lewisMW/agriculture-SoC/nanosoc/nanosoc_tech/nanosoc/slcorem0_tech/README.md

# SLCore M0 Tech

## SLCore-M0
SLCore M0 is a SoCLabs custom wrapper around the Arm Cortex-M0 designed to be integrated within the NanoSoC SoC.
