lewisMW/agriculture-SoC/analog/comparator_lib/comparator_v1_docs.md

# Comparator Documentation v1 @Today 8:59 AM

<aside>
💡

Block only works for DC input. If above 1V, the output is the high voltage, and if below, the output is the low voltage. 

</aside>

Quick results from February 17, 2026 9:04 AM:



Comparator Verilog A code 



Comparator testbench



5V DC input, 



500mV DC input
