lewisMW/agriculture-SoC/nanosoc/nanosoc_tech/doc/nanosoc_configuration_manual.pdf

# nanoSoC Configuration Manual

SoC Labs (http://www.soclabs.org)

October 30, 2025

Additional information.

You must run ’source set env.sh’ from the accelerator-project directory every time you open a new terminal!

Preamble, copyrights licenses etc.

1

# Contents

1 Introduction | 3
2 Adding your IP | 6
3 Simulating nanoSoC | 9
4 FPGA Flow | 12
5 ASIC Flow | 13

2

# Chapter 1

# Introduction

## 1.1 Summary

## 1.2 Repository Structure

The nanosoc-tech repository should be included as part of the accelerator-project repository. To use nanosoc please make sure you have cloned the accelerator-project repository as this contains IP that nanosoc needs in order to run correctly.
You can clone the accelerator-project using the command:
1 | git clone -- recurse - submodules \
2 | https :// git . soton . ac . uk / soclabs / accelerator - project . git
Below is the repository structure showing all the dependancies from the top level accelerator-project.
- accelerator-project (top level)

– accelerator-wrapper-tech (https://git.soton.ac.uk/soclabs/accelerator_wrapper_tech) – asic-lib-tech (https://git.soton.ac.uk/soclabs/asic_library_tech)
– fpga-lib-tech (https://git.soton.ac.uk/soclabs/fpga_lib_tech)
– generic-lib-tech (https://git.soton.ac.uk/soclabs/generic_lib_tech)
– nanosoc-tech (https://git.soton.ac.uk/soclabs/nanosoc_tech)
∗ sl-ams-tech (https://git.soton.ac.uk/soclabs/sl_ams_tech)
∗ slcorem0-tech (https://git.soton.ac.uk/soclabs/slcorem0_tech)
∗ sldma230-tech (https://git.soton.ac.uk/soclabs/sldma230_tech)
∗ sldm350-tech (https://git.soton.ac.uk/soclabs/sldma350_tech)
∗ socdebug-tech (https://git.soton.ac.uk/soclabs/socdebug_tech)
∗ synopsys-28nm-slm-integration (https://git.soton.ac.uk/soclabs/synopsys_28nm_slm_integration) – rtl-primitives-tech (https://git.soton.ac.uk/soclabs/rtl_primitives_tech)
– soctools-flow (https://git.soton.ac.uk/soclabs/soctools_flow)

3

## 1.3 IP

The nanoSoC reusable SoC platform relies on IP’s from certain vendors. In order to build the system you will need the following IP.

### 1.3.1 Arm(R)

Arm IP should be downloaded from Arm and placed into the recommended IP directories.

- Cortex-M0
- Corstone-101
- (Optional) PL230
- (Optional) DMA-350

### 1.3.2 SoCLabs

SoCLabs IP is all open domain and the repositories for these are automatically cloned into the nanosoc tech directories when you run a git clone.

- ASCII Debug Protocol Controller (SoCDebugTech Git) (https://git.soton.ac.uk/soclabs/socdebug_tech)
- FT1248 Controller (SoCDebugTech Git) (https://git.soton.ac.uk/soclabs/socdebug_tech)
- EXTIO Controller ( EXTIO8x4-axis Git) (https://git.soton.ac.uk/soclabs/extio8x4-axis)
- (Optional) PLL (for TSMC 65nm)
- (Optional) ADC (for TSMC 65nm)
- (Optional) DAC (for TSMC 65nm)

### 1.3.3 Synopsys

Synopsys IP is only used for chips that are taped out on a TSMC 28nm HPC+ node.

- (Optional) 3 GHz PLL
- (Optional) Silicon Lifetime Management

4

Additional information.

You must run ’source set env.sh’ from the accelerator-project directory every time you open a new terminal!

## 1.4 Environment Variables

When you run ’source set env.sh’ it sets up environment variables that are used by the tools (simulators, fpga, synthesis etc.). The main ones that are important for developing your IP are:
$SOCLABS PROJECT DIR - points to the accelerator-project directory $ACCELERATOR DIR - points to your accelerator directory

$ACCELERATOR DIR can be set up in the accelerator-project/env/dependency env.sh file using:

1 export ACCELERATOR \ _DIR =" $SOCLABS \ _PROJECT \ _DIR /** Your -IP - directory **"

5

# Chapter 2

# Adding your IP

In order to add the files for your IP there are 2 options. Either as a local version of your project or as a remote version.

1. Local version: you can just place your IP files into a new directory or in the system/src directory
2. Remote version: you can fork the accelerator-project git to your own git account, this allows you to add your IP either in the system/src directory or as a git submodule.

## 2.1 Integrating your IP

There are 2 steps to integrating your IP in nanosoc

1. Include your IP in the file list
2. Instantiate your IP in the system/src/accelerator subsystem.v file

For step 1. you can add paths to your files in the flist/project/accelerator.flist file. We recommend that you use the environment variables as mentioned in section 1.4. In order for fpga and asic flows to work properly you should split verilog and system verilog files into seperate .flist files. We suggest adding an accelerator sv.flist to the accelerator-project/flist/project directory and adding the following to accelerator.flist

-f $SOCLABS P ROJECT DIR/flist/project/accelerator sv.flist

For step 2. you need to edit the accelerator subsystem.v file (found in accelerator-project/system/src/). The ports of this file are an AHB-lite port, 2x EXP DRQ (data request from accelerator to DMA), 2x EXP DLAST (last signal from DMA to accelerator), 4x EXP IRQ (Interrupts from accelerator to CPU), and some AXI stream interfaces (these are only there if the DMA350 is configured with stream interfaces)

6

Additional information.

Add the option ACCELERATOR=yes to to include your accelerator when you run make commands!

## 2.2 Configuring nanoSoC

The nanoSoC reference design allows for some configuration flexibility. Most of these configuration options are in the accelerator-project/nanosoc.config file. In order to change this configuration, put a ’yes’ next to the relevant options to include these options, otherwise leave it blank.

### 2.2.1 DMA config

The DMA options are fundamentally:

- 1x PL230
- 2x PL230
- 1x DMA350

More details on these DMA IP’s are available from the Arm website.
The DMA-350 also has some extra configuration options
- DMA350 SMALL - Small configuration of DMA, 2 channels, no stream interface, no extended features
- DMA350 DEFAULT - Default configuration of DMA, 2 channels, stream interface, extended features
- DMA350 BIG - Big configuration of DMA, 3 channels, stream interface, extended features

If you use either the SMALL or BIG options for this, you must reconfigure the DMA-350. Follow the below steps:

1. cd to accelerator-project/nanosoc tech/nanosoc/sldma350 tech
2. run ’make clean ip’
3. run ’make config dma ahb small’ or ’make config dma ahb big’

## 2.3 Mixed signal IP

! Still under development !
You can also include mixed signal IP in this design. In order to do this you must also have the relevant IP for this

7

## 2.4 Synopsys IP

! Still under development !
If you are taping out with a TSMC 28nm node, and also have access to the Synopsys IP mentioned in section 1.3.3

8

# Chapter 3

# Simulating nanoSoC

## 3.1 Supported Simulators

- Mentor Graphics: QuestaSim
- Synopsys: VCS
- Cadence: Xcelium
- Icarus Verilog

## 3.2 Running Simulations

You can run make commands from the nanosoc tech directory to run the simulation.

1 | make run SIM = x TESTNAME =y ACCELERATOR = yes

Where x=mti, vcs, xm, or iverilog for QuestaSim, VCS, Xcelium, or Icarus Verilog respectively. And y is the name of the test, the default test is hello (a hello world example).
Or to run the simulation in the GUI you can use:
1 | make sim SIM = x TESTNAME =y ACCELERATOR = yes

Whilst the simulation is running, you should see the output from the UART std out channel in the console/terminal.

## 3.3 Adding Tests

To add your own testcodes to run on nanosoc in the simulation environment, you can add these to the accelerator-project/system/testcodes directory.

1. Create a new directory for your testcode

9

2. Create a .c source file with the same name as the directory
3. Copy the makefile from one of the example testcodes to your test code directory
4. Edit the TESTNAME variable in the new makefile to the name of your test
5. If you want to run any ADP code before your test, add an adp.cmp file (example in the adp v4 cmd tests)
6. If you want to preload expansion memories, add an expram l.hex and/or expram h.hex
7. Add the name of your test to the accelerator-project/system/software list.txt file

### 3.3.1 Creating your C code

The below code is a basic layout for your C code. It initialises the standard out channel over UART. You can then use printf statements that will output over UART, which will be printed on the console output.
The UartEndSimulation() function sends an escape character over UART, which the testbench will use to end the simulation.
1 | # include " CMSDK_CM0 .h"
2 | # include " uart_stdout .h"
3 | # include < stdio .h >

4
5 | int main ( void ) {
6 | // Initialise the UART standard out channel
7 | UartStdOutInit () ;

8
9 | printf ("Foo\n"); // Print over UART stdout

10
11 | /* Insert your code here */

12
13 | // End simulation by sending escape char
14 | UartEndSimulation () ;
15 | return 0;
16 | }
Listing 3.1: Basic Template

For more detailed C code templates, please see the firmware in the accelerator-project/nanosoc tech/software/common/validation. These are also the testcodes used for validating nanoSoC.

### 3.3.2 Preloading expansion memories

You may want to load test vectors directly into the expansion memories to run your tests. Doing this can save space in the instruction memory space as you then don’t have to load data in as arrays or vectors in your testcode. Instead

10 you can use the simulator to automatically load these memories at the start of simulation.
To do this, simply add an ”expram l.hex” file and/or ”expram h.hex” file to your testcode directory. These files will then be loaded to the EXPRAM L or EXPRAM H region repectively. These can then be addressed in your testcode from 0x80000000 for EXPRAM L and 0x90000000 for EXPRAM H.
The expram l.hex files must be ASCII text files with a single byte per line. They will look very similar to the .hex files that are used to preload the instruction memory.

11

# Chapter 4

# FPGA Flow

## 4.1 Summary

## 4.2 Building the FPGA image

To build the FPGA image, run the below command from the nanosoc tech directory:

1 | make build_fpga ACCELERATOR = yes FPGA =x

Where x is either zcu104, mps3, kr260, kv260, z2. If you would like another FPGA target to be included please contact the soclabs team or raise an issue on the accelerator-project git.

## 4.3 Running test code on the FPGA

12

# Chapter 5

# ASIC Flow

## 5.1 Technology Selection

When taping out any design it is important to consider the technology node. The choice of node will impact the power, performance and area (PPA) metrics. And along with area, the cost will also vary from node to node. Below we have compiled some metrics on nanosoc with different nodes and configurations

Technology Node | Configuration | Max
Freq (MHz)

Area
(mm²
)
TSMC 65nm (12-track) | 16kB IMEM and DMEM
8kB EXPRAM L and H | 240 | 1.5
TSMC 65nm (12-track) | 16kB IMEM and DMEM
16kB EXPRAM L and H | 240 | 2
GF 180 | 8kB IMEM and DMEM
4kB EXPRAM L and H | 50 | 6

## 5.2 Cadence ASIC Flow: TSMC 65nm

The following shows how to run the ASIC flow using Cadence Software for a TSMC 65nm implementation

1 | make gen_memories
2 | make flist_genus_nanosoc ASIC = yes ACCELERATOR = yes NODE =65
3 | make cadence_synthesis ASIC = yes NODE =65
4 | make cadence_pnr_setup ASIC = yes NODE =65

13
