lewisMW/agriculture-SoC/nanosoc/nanosoc_tech/testcodes/excluded_tests.txt

rtx_demo
gpio_tests
dma350_stream_tests
uart_tests
uart_driver_tests
