lewisMW/agriculture-SoC/nanosoc/nanosoc_tech/testcodes/software_list.txt

rtx_demo
gpio_tests
hello
dhry
sleep_demo
dualtimer_demo
self_reset_demo
watchdog_demo
timer_tests
debug_tests
default_slaves_tests
dma_tests
dma350_tests
gpio_driver_tests
timer_driver_tests
apb_mux_tests
memory_tests
romtable_tests
interrupt_demo
dataio_tests
dataio_dma230_tests
