lewisMW/agriculture-SoC/nanosoc/system/testcodes/software_list.txt

adc_trigger_test
fifo_drain_test
rtc_time_test
adc_autonomous_test
