lewisMW/agriculture-SoC/nanosoc/nanosoc_tech/hostio4/tb/asc-test.txt

0123456789ABCDEF
123456789ABCDEF
3456789ABCDEF
456789ABCDEF
56789ABCDEF
6789ABCDEF
789ABCDEF
89ABCDEF
9ABCDEF
ABCDEF
BCDEF
CDEF
DEF
EF
EF
abcdefghijklmnopqrstuvwxyz
abcdefghijklmnopqrstuvwxyz
abcdefghijklmnopqrstuvwxyz
abcdefghijklmnopqrstuvwxyz
abcdefghijklmnopqrstuvwxyz
abcdefghijklmnopqrstuvwxyz
abcdefghijklmnopqrstuvwxyz
abcdefghijklmnopqrstuvwxyz
*END*
