lewisMW/agriculture-SoC/(threads)

Thread 3 (2024-05-17):

Project submission form + Milestones

lewisMW, 2024-05-17:
Fill out the project submission form and milestones [here](https://unisydneyedu-my.sharepoint.com/:w:/g/personal/lwat0045_uni_sydney_edu_au/ETINbAPwxZhPrn57SC2FBakBDUp79QfLtQkZGyDaJh7H_g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).
- Body: Hee, Jaime, Shin
- Milestones: Patrick, KeZhi, Erick, Adrian, Daniel, Josh

pgaft, 2024-05-20:
Milestone: Determine which ARM IP are applicable to our design.

pgaft, 2024-05-20:
Milestone: Determine project scope and focus.

pgaft, 2024-05-20:
Generic Milestone: <ARM IP> implementation and interfacing

womba, 2024-05-20:
Milestone: Verification of Digital Design?

womba, 2024-05-20:
Milestone: Software configuration and programming.

AbacusIsMad, 2024-05-20:
Milestone: run example design flow using cortex-M0 (placeholder) and GPIO for familiarity

Closed 2024-05-31.

Thread 8 (2024-12-11):

Create AHB or APB wrappers.

lewisMW, 2024-12-11:
o	Investigate the Wrapper files in SoC Contest 2024/Resources/SoC-design-and-prototyping-Research-Enablement-Kit/cm0_soc_code/cm0_fpu/hw/wrappers/.
o	Create a wrapper for the ADC, like the one from  https://soclabs.org/project/adc-integration-nanosoc.

- Consider where to put timer
- Consider how to go about doing APB interface

sandinj, 2024-12-11:
Drafted address specifications, and edited wrapper to reflect these specifications.

sandinj, 2025-01-24:
Formalised address specifications and documentation, including specifying address offsets. These addresses have been implemented in verilog.

Closed 2025-02-02.

Thread 10 (2025-01-15):

RTC/Timer IP

lewisMW, 2025-01-15:
- [x] Implement or find IP that suit spec.
- [x] Instantiate the IP into the wrapper code.
- [ ] Create a simple FSM to control the IP's (APB interface) - you will need to make sure the timing is correct as per the Arm documentation.
- [ ] Create a simple unit test (e.g. traversing the FSM).
- [ ] Create specs, docs and unit test description (input/output/description) [here:](https://unisydneyedu-my.sharepoint.com/:w:/g/personal/lwat0045_alumni_sydney_edu_au/EZJQlrRwf0pDgi94zrjHnGgBlbid-Y7o1PqV0c9euZl2bg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)

pgaft, 2025-01-28:
Found the PL031 RTC which is a suitable IP for this use case. Since we are currently unable to access AAA IP, a dummy RTC has been implemented on the adc-apb-wrapper branch.

lewisMW, 2025-02-02:
@pgaft I've just checked and we should have access to https://developer.arm.com/downloads/view/PL031?sortBy=availableBy&revision=r1p3-00rel0-2 now.

Closed 2025-04-04.

Thread 11 (2025-01-15):

Design Specs

lewisMW, 2025-01-15:
**4/2/25**
Create specs for each block. Document in the OneDrive!

**26/6/2024**
Sensor types discussed in meeting 26/6/24.
* See Discord for info.
* Add to the OneDrive in the Analog team folder. Use Word or Excel or simply a Markdown file.

**Guide**: Start by imagining a live demonstration of the SoC (on PCB) with sensors at a conference poster session. This can be a fairly controlled environment. What specifications are required for this demo? Per sensor, system level then per component, etc.

EGoliath, 2025-01-19:
https://unisydneyedu-my.sharepoint.com/:w:/g/personal/lwat0045_uni_sydney_edu_au/EY3tUiBB1OVOr_8obefjqW4B51tYOqsHgOD0_Yqsru4BOQ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

moiseskim98, 2025-02-15:
The document that is currently under work is [https://unisydneyedu-my.sharepoint.com/:w:/g/personal/lwat0045_alumni_sydney_edu_au/EW3dMYCGrS5BoNUJLPtlWuYB4M3Je95smwskv35AX_L_Bg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](link)

It includes the theory of the principle used by the sensor, high level specs, and the proposed design for this project

Closed 2025-09-29.

Thread 24 (2025-02-16):

Investigate M0 sleep features

lewisMW, 2025-02-16:
- [x] Read the ARM docs on [M0 power management](https://developer.arm.com/documentation/dui0497/a/the-cortex-m0-processor/power-management) to get an idea of what Cortex M0 features we can use to optimise for a low-power design.
- [x] Determine the feasibility of our design being able to use the _**deep sleep**_ state and what we need to do to use it - how do we put the processor in deep sleep and how do we wake it up?

Kezhipu, 2025-02-22:
feasibility of our design being able to use the deep sleep state：
Based on our agricultural SoCs for sensing and monitoring of field environments, it is important to balance sensing accuracy with power consumption to meet long endurance.And sensors are often “event” driven : when a sensor detects an abnormality (sudden drop in humidity, gas concentration exceeding the limit, etc.), the SoC needs to wake up in time to handle the situation. Most of the time, it can be put to sleep to save energy.
From Doc, we know that the Cortex-M0 core supports two low-power states: Sleep and Deep Sleep：
Deep Sleep can further turn off the system clock and some peripherals such as PLL and Flash memory, which is more power efficient than normal Sleep.
**But from the discussion with Lewis last week, we may need to keep some of the clocks off. (basically feasible)**
And in Deep Sleep, traditional interrupts cannot directly wake up the processor because the main clock may be turned off; while WIC (Wakeup Interrupt Controller) monitors the interrupt line and quickly restores the system clock and wakes up the kernel when it detects a valid signal. This helps to significantly reduce standby power consumption while still maintaining real-time response to external sensors or events. So WIC is a must.

Kezhipu, 2025-02-22:
Entering Deep Sleep Mode

**1. Setting the SLEEPDEEP bit：**
    Before entering Deep Sleep, you need to set the SLEEPDEEP bit in the System Control Register (SCB->SCR).
**2. Execute the sleep command**
    **__WFI()** (Wait For Interrupt) or **__WFE()** (Wait For Event) can be selected：
    __WFI() (Wait For Interrupt): Immediately goes to sleep after execution and waits for interrupt to wake up.
    __WFE() (Wait For Event): if there is no “event” flag, then sleep, otherwise execution continues.
Personally, I think our best choice is **WFI** because it is the most energy efficient, completely stopping until an external interrupt is triggered. And it can be used in conjunction with WIC, and as we can see later, the way we wake up also depends entirely on the way we go to sleep!
   3.Of course, in order to further reduce power consumption, peripherals that are not relevant to the current stage can be turned off by the clock controller or a lower frequency clock source can be used. For example we can keep only the low power timers or critical paths like GPIO input detection.

Kezhipu, 2025-02-22:
Wake Up from Deep Sleep Mode:

As I said before, the mothed of waking up depends on how do we enter deep sleep:
Since we are using WFI, and since the Cortex-M0 shuts down system clocks in deep sleep, traditional interrupt detection won’t work. We have to use **WIC** and even without needing the main clock!

Closed 2025-03-01.

Thread 33 (2025-07-07):

RTL Verification

lewisMW, 2025-07-07:
Complete porting over the integration tests from DesignStart to NanoSoC.

lewisMW, 2025-08-12:
1.5hr
* Converted old tests to new tests (5x tests?)
3hr
* Setup ARM IP (From @lewisMW docs)
* Setup NanoSoC (from readme above)
* Run tests
* Debugging (please DM @lewisMW if you get stuck).

lewisMW, 2025-08-28:
26/8 to 2/9: 3hr
-  [ ] Debugging (please DM @lewisMW if you get stuck).

lewisMW, 2025-09-09:
9/9 to 16/9: 3hrs
- [ ] PR
- [ ] Create new random tests.

lewisMW, 2025-09-16:
16/9 to 23/9: 0.5hrs
- [ ] printf format study
23/9 to 30/9
- [ ] PR for test fixes
- [ ] Create new random tests.

lewisMW, 2025-09-22:
22/9 - 29/9: 4hrs
- [ ] PR for test fixes
- [ ] Create new random tests.
- [ ] printf format study

lewisMW, 2025-09-29:
29/9 - 6/10: ?
- [ ] PR for test fixes
- [ ]

Thread 36 (2025-07-07):

RTL Verification (FPGA)

lewisMW, 2025-07-07:
Verify our custom RTL + NanoSoC on an FPGA, with mock ADC input.

lewisMW, 2025-08-12:
12/8 to 19/8: 5hr
* Get NanoSoC on the FPGA (without our IP)
* Ask Daniel for help (don't be shy)

lewisMW, 2025-08-28:
26/8 to 2/9: 2hrs
- [ ] Super quick follow up to Daniel tomorrow
- [ ] Fiddle around with FPGA build - Getting Windows Vivado to speak to WSL NanoSoC

lewisMW, 2025-09-29:
29/9 - 6/10: 2hrs
- [ ] Upload to the board.

pgaft, 2025-10-06:
6/10 - 13/10: 2 hrs

- [ ]  Ideate how to verify our design on the board.

Thread 38 (2025-08-25):

Understand "ADC integration in nanoSoC"

moiseskim98, 2025-08-25:
Read [ADC integration in nanoSoC](https://soclabs.org/project/adc-integration-nanosoc).

Understand the scope of the project, SAR ADC principle, and requirements.
Understand the workflow of the project. Requirements -> Verilog AMS -> Simulation -> Schematic -> Simulation
Identify key components, e.g., op-amp for the comparator, ADC functional blocks (Comparator, DAC, sample and hold).

Closed 2025-09-20.

Thread 41 (2025-09-20):

Filter

moiseskim98, 2025-09-20:
Low pass filter as a pre stage to the ADC. Build verilog AMS block

lewisMW, 2025-09-29:
22/9 - 29/9: ?hrs
- [ ] ?

lewisMW, 2025-09-29:
29/9 - 6/10: 0.5hrs (Jaime)
- [ ] Look at how to port over the Gain AMS model over.
