lewisMW/agriculture-SoC/nanosoc/nanosoc_tech/fpga/targets/pynq_zcu104/fpga_pinmap.xdc

##################################################################################
##                                                                              ##
## ZCU104 Rev1.0 Master XDC                                                     ##
##                                                                              ##
##################################################################################

#Other net   PACKAGE_PIN V17      - SYSMON_DXN                Bank   0 - DXN
#Other net   PACKAGE_PIN V18      - SYSMON_DXP                Bank   0 - DXP
#Other net   PACKAGE_PIN R17      - SYSMON_AGND               Bank   0 - GNDADC
#Other net   PACKAGE_PIN AA12     - 3N5824                    Bank   0 - POR_OVERRIDE
#Other net   PACKAGE_PIN AA13     - 3N5822                    Bank   0 - PUDC_B
#Other net   PACKAGE_PIN R18      - FPGA_SYSMON_AVCC          Bank   0 - VCCADC
#Other net   PACKAGE_PIN U17      - SYSMON_VN_R               Bank   0 - VN
#Other net   PACKAGE_PIN T18      - SYSMON_VP_R               Bank   0 - VP
#Other net   PACKAGE_PIN T17      - SYSMON_AGND               Bank   0 - VREFN
#Other net   PACKAGE_PIN U18      - SYSMON_AGND               Bank   0 - VREFP
#set_property PACKAGE_PIN B21      [get_ports "5N7582"] ;# Bank  28 VCCO - VCC1V8   - IO_L24N_T3U_N11_28
#set_property IOSTANDARD  LVCMOSxx [get_ports "5N7582"] ;# Bank  28 VCCO - VCC1V8   - IO_L24N_T3U_N11_28
#set_property PACKAGE_PIN B20      [get_ports "5N7577"] ;# Bank  28 VCCO - VCC1V8   - IO_L24P_T3U_N10_28
#set_property IOSTANDARD  LVCMOSxx [get_ports "5N7577"] ;# Bank  28 VCCO - VCC1V8   - IO_L24P_T3U_N10_28
#set_property PACKAGE_PIN A23      [get_ports "5N7578"] ;# Bank  28 VCCO - VCC1V8   - IO_L23N_T3U_N9_28
#set_property IOSTANDARD  LVCMOSxx [get_ports "5N7578"] ;# Bank  28 VCCO - VCC1V8   - IO_L23N_T3U_N9_28
#set_property PACKAGE_PIN A22      [get_ports "5N7569"] ;# Bank  28 VCCO - VCC1V8   - IO_L23P_T3U_N8_28
#set_property IOSTANDARD  LVCMOSxx [get_ports "5N7569"] ;# Bank  28 VCCO - VCC1V8   - IO_L23P_T3U_N8_28
#set_property PACKAGE_PIN B19      [get_ports "5N7570"] ;# Bank  28 VCCO - VCC1V8   - IO_L22N_T3U_N7_DBC_AD0N_28
#set_property IOSTANDARD  LVCMOSxx [get_ports "5N7570"] ;# Bank  28 VCCO - VCC1V8   - IO_L22N_T3U_N7_DBC_AD0N_28
#set_property PACKAGE_PIN B18      [get_ports "5N7565"] ;# Bank  28 VCCO - VCC1V8   - IO_L22P_T3U_N6_DBC_AD0P_28
#set_property IOSTANDARD  LVCMOSxx [get_ports "5N7565"] ;# Bank  28 VCCO - VCC1V8   - IO_L22P_T3U_N6_DBC_AD0P_28
#set_property PACKAGE_PIN A21      [get_ports "5N7709"] ;# Bank  28 VCCO - VCC1V8   - IO_L21N_T3L_N5_AD8N_28
#set_property IOSTANDARD  LVCMOSxx [get_ports "5N7709"] ;# Bank  28 VCCO - VCC1V8   - IO_L21N_T3L_N5_AD8N_28
#set_property PACKAGE_PIN A18      [get_ports "5N7704"] ;# Bank  28 VCCO - VCC1V8   - IO_L19P_T3L_N0_DBC_AD9P_28
#set_property IOSTANDARD  LVCMOSxx [get_ports "5N7704"] ;# Bank  28 VCCO - VCC1V8   - IO_L19P_T3L_N0_DBC_AD9P_28
#set_property PACKAGE_PIN B23      [get_ports "5N7581"] ;# Bank  28 VCCO - VCC1V8   - IO_T3U_N12_28
#set_property IOSTANDARD  LVCMOSxx [get_ports "5N7581"] ;# Bank  28 VCCO - VCC1V8   - IO_T3U_N12_28
#set_property PACKAGE_PIN F25      [get_ports "5N7703"] ;# Bank  28 VCCO - VCC1V8   - IO_T2U_N12_28
#set_property IOSTANDARD  LVCMOSxx [get_ports "5N7703"] ;# Bank  28 VCCO - VCC1V8   - IO_T2U_N12_28
#set_property PACKAGE_PIN G26      [get_ports "5N7702"] ;# Bank  28 VCCO - VCC1V8   - IO_L18N_T2U_N11_AD2N_28
#set_property IOSTANDARD  LVCMOSxx [get_ports "5N7702"] ;# Bank  28 VCCO - VCC1V8   - IO_L18N_T2U_N11_AD2N_28
#set_property PACKAGE_PIN G25      [get_ports "5N7694"] ;# Bank  28 VCCO - VCC1V8   - IO_L18P_T2U_N10_AD2P_28
#set_property IOSTANDARD  LVCMOSxx [get_ports "5N7694"] ;# Bank  28 VCCO - VCC1V8   - IO_L18P_T2U_N10_AD2P_28
#set_property PACKAGE_PIN C23      [get_ports "5N7693"] ;# Bank  28 VCCO - VCC1V8   - IO_L17N_T2U_N9_AD10N_28
#set_property IOSTANDARD  LVCMOSxx [get_ports "5N7693"] ;# Bank  28 VCCO - VCC1V8   - IO_L17N_T2U_N9_AD10N_28
#set_property PACKAGE_PIN D22      [get_ports "5N7690"] ;# Bank  28 VCCO - VCC1V8   - IO_L17P_T2U_N8_AD10P_28
#set_property IOSTANDARD  LVCMOSxx [get_ports "5N7690"] ;# Bank  28 VCCO - VCC1V8   - IO_L17P_T2U_N8_AD10P_28
#set_property PACKAGE_PIN D24      [get_ports "5N7688"] ;# Bank  28 VCCO - VCC1V8   - IO_L16N_T2U_N7_QBC_AD3N_28
#set_property IOSTANDARD  LVCMOSxx [get_ports "5N7688"] ;# Bank  28 VCCO - VCC1V8   - IO_L16N_T2U_N7_QBC_AD3N_28
#set_property PACKAGE_PIN E24      [get_ports "5N7682"] ;# Bank  28 VCCO - VCC1V8   - IO_L16P_T2U_N6_QBC_AD3P_28
#set_property IOSTANDARD  LVCMOSxx [get_ports "5N7682"] ;# Bank  28 VCCO - VCC1V8   - IO_L16P_T2U_N6_QBC_AD3P_28
#set_property PACKAGE_PIN C22      [get_ports "5N7681"] ;# Bank  28 VCCO - VCC1V8   - IO_L15N_T2L_N5_AD11N_28
#set_property IOSTANDARD  LVCMOSxx [get_ports "5N7681"] ;# Bank  28 VCCO - VCC1V8   - IO_L15N_T2L_N5_AD11N_28
#set_property PACKAGE_PIN C21      [get_ports "5N7678"] ;# Bank  28 VCCO - VCC1V8   - IO_L15P_T2L_N4_AD11P_28
#set_property IOSTANDARD  LVCMOSxx [get_ports "5N7678"] ;# Bank  28 VCCO - VCC1V8   - IO_L15P_T2L_N4_AD11P_28
#set_property PACKAGE_PIN G24      [get_ports "5N7676"] ;# Bank  28 VCCO - VCC1V8   - IO_L14N_T2L_N3_GC_28
#set_property IOSTANDARD  LVCMOSxx [get_ports "5N7676"] ;# Bank  28 VCCO - VCC1V8   - IO_L14N_T2L_N3_GC_28
#set_property PACKAGE_PIN G23      [get_ports "5N7672"] ;# Bank  28 VCCO - VCC1V8   - IO_L14P_T2L_N2_GC_28
#set_property IOSTANDARD  LVCMOSxx [get_ports "5N7672"] ;# Bank  28 VCCO - VCC1V8   - IO_L14P_T2L_N2_GC_28
#set_property PACKAGE_PIN F20      [get_ports "5N7532"] ;# Bank  28 VCCO - VCC1V8   - IO_L10N_T1U_N7_QBC_AD4N_28
#set_property IOSTANDARD  LVCMOSxx [get_ports "5N7532"] ;# Bank  28 VCCO - VCC1V8   - IO_L10N_T1U_N7_QBC_AD4N_28
#set_property PACKAGE_PIN G20      [get_ports "5N7533"] ;# Bank  28 VCCO - VCC1V8   - IO_L10P_T1U_N6_QBC_AD4P_28
#set_property IOSTANDARD  LVCMOSxx [get_ports "5N7533"] ;# Bank  28 VCCO - VCC1V8   - IO_L10P_T1U_N6_QBC_AD4P_28
#set_property PACKAGE_PIN D21      [get_ports "5N7524"] ;# Bank  28 VCCO - VCC1V8   - IO_L9N_T1L_N5_AD12N_28
#set_property IOSTANDARD  LVCMOSxx [get_ports "5N7524"] ;# Bank  28 VCCO - VCC1V8   - IO_L9N_T1L_N5_AD12N_28
#set_property PACKAGE_PIN D20      [get_ports "5N7525"] ;# Bank  28 VCCO - VCC1V8   - IO_L9P_T1L_N4_AD12P_28
#set_property IOSTANDARD  LVCMOSxx [get_ports "5N7525"] ;# Bank  28 VCCO - VCC1V8   - IO_L9P_T1L_N4_AD12P_28
#set_property PACKAGE_PIN H22      [get_ports "5N7520"] ;# Bank  28 VCCO - VCC1V8   - IO_L8N_T1L_N3_AD5N_28
#set_property IOSTANDARD  LVCMOSxx [get_ports "5N7520"] ;# Bank  28 VCCO - VCC1V8   - IO_L8N_T1L_N3_AD5N_28
#set_property PACKAGE_PIN H21      [get_ports "5N7521"] ;# Bank  28 VCCO - VCC1V8   - IO_L8P_T1L_N2_AD5P_28
#set_property IOSTANDARD  LVCMOSxx [get_ports "5N7521"] ;# Bank  28 VCCO - VCC1V8   - IO_L8P_T1L_N2_AD5P_28
#set_property PACKAGE_PIN D19      [get_ports "5N7512"] ;# Bank  28 VCCO - VCC1V8   - IO_L7N_T1L_N1_QBC_AD13N_28
#set_property IOSTANDARD  LVCMOSxx [get_ports "5N7512"] ;# Bank  28 VCCO - VCC1V8   - IO_L7N_T1L_N1_QBC_AD13N_28
#set_property PACKAGE_PIN E19      [get_ports "5N7513"] ;# Bank  28 VCCO - VCC1V8   - IO_L7P_T1L_N0_QBC_AD13P_28
#set_property IOSTANDARD  LVCMOSxx [get_ports "5N7513"] ;# Bank  28 VCCO - VCC1V8   - IO_L7P_T1L_N0_QBC_AD13P_28
#set_property PACKAGE_PIN E20      [get_ports "5N7726"] ;# Bank  28 VCCO - VCC1V8   - IO_T1U_N12_28
#set_property IOSTANDARD  LVCMOSxx [get_ports "5N7726"] ;# Bank  28 VCCO - VCC1V8   - IO_T1U_N12_28
#set_property PACKAGE_PIN H23      [get_ports "5N7508"] ;# Bank  28 VCCO - VCC1V8   - IO_T0U_N12_VRP_28
#set_property IOSTANDARD  LVCMOSxx [get_ports "5N7508"] ;# Bank  28 VCCO - VCC1V8   - IO_T0U_N12_VRP_28
#set_property PACKAGE_PIN H24      [get_ports "5N7509"] ;# Bank  28 VCCO - VCC1V8   - IO_L6N_T0U_N11_AD6N_28
#set_property IOSTANDARD  LVCMOSxx [get_ports "5N7509"] ;# Bank  28 VCCO - VCC1V8   - IO_L6N_T0U_N11_AD6N_28
#set_property PACKAGE_PIN J24      [get_ports "5N7500"] ;# Bank  28 VCCO - VCC1V8   - IO_L6P_T0U_N10_AD6P_28
#set_property IOSTANDARD  LVCMOSxx [get_ports "5N7500"] ;# Bank  28 VCCO - VCC1V8   - IO_L6P_T0U_N10_AD6P_28
#set_property PACKAGE_PIN H26      [get_ports "5N7501"] ;# Bank  28 VCCO - VCC1V8   - IO_L5N_T0U_N9_AD14N_28
#set_property IOSTANDARD  LVCMOSxx [get_ports "5N7501"] ;# Bank  28 VCCO - VCC1V8   - IO_L5N_T0U_N9_AD14N_28
#set_property PACKAGE_PIN J25      [get_ports "5N7496"] ;# Bank  28 VCCO - VCC1V8   - IO_L5P_T0U_N8_AD14P_28
#set_property IOSTANDARD  LVCMOSxx [get_ports "5N7496"] ;# Bank  28 VCCO - VCC1V8   - IO_L5P_T0U_N8_AD14P_28
#set_property PACKAGE_PIN K23      [get_ports "5N7497"] ;# Bank  28 VCCO - VCC1V8   - IO_L4N_T0U_N7_DBC_AD7N_28
#set_property IOSTANDARD  LVCMOSxx [get_ports "5N7497"] ;# Bank  28 VCCO - VCC1V8   - IO_L4N_T0U_N7_DBC_AD7N_28
#set_property PACKAGE_PIN K22      [get_ports "5N7488"] ;# Bank  28 VCCO - VCC1V8   - IO_L4P_T0U_N6_DBC_AD7P_28
#set_property IOSTANDARD  LVCMOSxx [get_ports "5N7488"] ;# Bank  28 VCCO - VCC1V8   - IO_L4P_T0U_N6_DBC_AD7P_28
#set_property PACKAGE_PIN J22      [get_ports "5N7489"] ;# Bank  28 VCCO - VCC1V8   - IO_L3N_T0L_N5_AD15N_28
#set_property IOSTANDARD  LVCMOSxx [get_ports "5N7489"] ;# Bank  28 VCCO - VCC1V8   - IO_L3N_T0L_N5_AD15N_28
#set_property PACKAGE_PIN J21      [get_ports "5N7484"] ;# Bank  28 VCCO - VCC1V8   - IO_L3P_T0L_N4_AD15P_28
#set_property IOSTANDARD  LVCMOSxx [get_ports "5N7484"] ;# Bank  28 VCCO - VCC1V8   - IO_L3P_T0L_N4_AD15P_28
#set_property PACKAGE_PIN K24      [get_ports "5N7485"] ;# Bank  28 VCCO - VCC1V8   - IO_L2N_T0L_N3_28
#set_property IOSTANDARD  LVCMOSxx [get_ports "5N7485"] ;# Bank  28 VCCO - VCC1V8   - IO_L2N_T0L_N3_28
#set_property PACKAGE_PIN L23      [get_ports "5N7476"] ;# Bank  28 VCCO - VCC1V8   - IO_L2P_T0L_N2_28
#set_property IOSTANDARD  LVCMOSxx [get_ports "5N7476"] ;# Bank  28 VCCO - VCC1V8   - IO_L2P_T0L_N2_28
#set_property PACKAGE_PIN L22      [get_ports "5N7477"] ;# Bank  28 VCCO - VCC1V8   - IO_L1N_T0L_N1_DBC_28
#set_property IOSTANDARD  LVCMOSxx [get_ports "5N7477"] ;# Bank  28 VCCO - VCC1V8   - IO_L1N_T0L_N1_DBC_28
#set_property PACKAGE_PIN L21      [get_ports "5N7472"] ;# Bank  28 VCCO - VCC1V8   - IO_L1P_T0L_N0_DBC_28
#set_property IOSTANDARD  LVCMOSxx [get_ports "5N7472"] ;# Bank  28 VCCO - VCC1V8   - IO_L1P_T0L_N0_DBC_28
#Other net   PACKAGE_PIN M23      - 5N7631                    Bank  28 - VREF_28
#set_property PACKAGE_PIN A9       [get_ports "4N9784"] ;# Bank  68 VCCO - VADJ_FMC - IO_T3U_N12_68
#set_property IOSTANDARD  LVCMOSxx [get_ports "4N9784"] ;# Bank  68 VCCO - VADJ_FMC - IO_T3U_N12_68
#set_property PACKAGE_PIN G13      [get_ports "4N9781"] ;# Bank  68 VCCO - VADJ_FMC - IO_T2U_N12_68
#set_property IOSTANDARD  LVCMOSxx [get_ports "4N9781"] ;# Bank  68 VCCO - VADJ_FMC - IO_T2U_N12_68
#set_property PACKAGE_PIN G11      [get_ports "4N9820"] ;# Bank  68 VCCO - VADJ_FMC - IO_L13N_T2L_N1_GC_QBC_68
#set_property IOSTANDARD  LVCMOSxx [get_ports "4N9820"] ;# Bank  68 VCCO - VADJ_FMC - IO_L13N_T2L_N1_GC_QBC_68
#set_property PACKAGE_PIN H11      [get_ports "4N9817"] ;# Bank  68 VCCO - VADJ_FMC - IO_L13P_T2L_N0_GC_QBC_68
#set_property IOSTANDARD  LVCMOSxx [get_ports "4N9817"] ;# Bank  68 VCCO - VADJ_FMC - IO_L13P_T2L_N0_GC_QBC_68
#set_property PACKAGE_PIN G9       [get_ports "4N9823"] ;# Bank  68 VCCO - VADJ_FMC - IO_L11N_T1U_N9_GC_68
#set_property IOSTANDARD  LVCMOSxx [get_ports "4N9823"] ;# Bank  68 VCCO - VADJ_FMC - IO_L11N_T1U_N9_GC_68
#set_property PACKAGE_PIN H9       [get_ports "4N9826"] ;# Bank  68 VCCO - VADJ_FMC - IO_L11P_T1U_N8_GC_68
#set_property IOSTANDARD  LVCMOSxx [get_ports "4N9826"] ;# Bank  68 VCCO - VADJ_FMC - IO_L11P_T1U_N8_GC_68
#set_property PACKAGE_PIN D7       [get_ports "4N9778"] ;# Bank  68 VCCO - VADJ_FMC - IO_T1U_N12_68
#set_property IOSTANDARD  LVCMOSxx [get_ports "4N9778"] ;# Bank  68 VCCO - VADJ_FMC - IO_T1U_N12_68
#set_property PACKAGE_PIN H14      [get_ports "VRP_68"] ;# Bank  68 VCCO - VADJ_FMC - IO_T0U_N12_VRP_68
#set_property IOSTANDARD  LVCMOSxx [get_ports "VRP_68"] ;# Bank  68 VCCO - VADJ_FMC - IO_T0U_N12_VRP_68
#set_property PACKAGE_PIN K13      [get_ports "4N9759"] ;# Bank  68 VCCO - VADJ_FMC - IO_L6N_T0U_N11_AD6N_68
#set_property IOSTANDARD  LVCMOSxx [get_ports "4N9759"] ;# Bank  68 VCCO - VADJ_FMC - IO_L6N_T0U_N11_AD6N_68
#set_property PACKAGE_PIN L14      [get_ports "4N9760"] ;# Bank  68 VCCO - VADJ_FMC - IO_L6P_T0U_N10_AD6P_68
#set_property IOSTANDARD  LVCMOSxx [get_ports "4N9760"] ;# Bank  68 VCCO - VADJ_FMC - IO_L6P_T0U_N10_AD6P_68
#set_property PACKAGE_PIN J14      [get_ports "4N9755"] ;# Bank  68 VCCO - VADJ_FMC - IO_L5N_T0U_N9_AD14N_68
#set_property IOSTANDARD  LVCMOSxx [get_ports "4N9755"] ;# Bank  68 VCCO - VADJ_FMC - IO_L5N_T0U_N9_AD14N_68
#set_property PACKAGE_PIN K14      [get_ports "4N9756"] ;# Bank  68 VCCO - VADJ_FMC - IO_L5P_T0U_N8_AD14P_68
#set_property IOSTANDARD  LVCMOSxx [get_ports "4N9756"] ;# Bank  68 VCCO - VADJ_FMC - IO_L5P_T0U_N8_AD14P_68
#set_property PACKAGE_PIN J11      [get_ports "4N9771"] ;# Bank  68 VCCO - VADJ_FMC - IO_L4N_T0U_N7_DBC_AD7N_68
#set_property IOSTANDARD  LVCMOSxx [get_ports "4N9771"] ;# Bank  68 VCCO - VADJ_FMC - IO_L4N_T0U_N7_DBC_AD7N_68
#set_property PACKAGE_PIN K12      [get_ports "4N9772"] ;# Bank  68 VCCO - VADJ_FMC - IO_L4P_T0U_N6_DBC_AD7P_68
#set_property IOSTANDARD  LVCMOSxx [get_ports "4N9772"] ;# Bank  68 VCCO - VADJ_FMC - IO_L4P_T0U_N6_DBC_AD7P_68
#set_property PACKAGE_PIN L11      [get_ports "4N9767"] ;# Bank  68 VCCO - VADJ_FMC - IO_L3N_T0L_N5_AD15N_68
#set_property IOSTANDARD  LVCMOSxx [get_ports "4N9767"] ;# Bank  68 VCCO - VADJ_FMC - IO_L3N_T0L_N5_AD15N_68
#set_property PACKAGE_PIN L12      [get_ports "4N9768"] ;# Bank  68 VCCO - VADJ_FMC - IO_L3P_T0L_N4_AD15P_68
#set_property IOSTANDARD  LVCMOSxx [get_ports "4N9768"] ;# Bank  68 VCCO - VADJ_FMC - IO_L3P_T0L_N4_AD15P_68
#Other net   PACKAGE_PIN J12      - 4N9503                    Bank  68 - VREF_68
#set_property PACKAGE_PIN J20      [get_ports "7N10213"] ;# Bank  67 VCCO - VADJ_FMC - IO_T3U_N12_67
#set_property IOSTANDARD  LVCMOSxx [get_ports "7N10213"] ;# Bank  67 VCCO - VADJ_FMC - IO_T3U_N12_67
#set_property PACKAGE_PIN J19      [get_ports "7N10210"] ;# Bank  67 VCCO - VADJ_FMC - IO_T2U_N12_67
#set_property IOSTANDARD  LVCMOSxx [get_ports "7N10210"] ;# Bank  67 VCCO - VADJ_FMC - IO_T2U_N12_67
#set_property PACKAGE_PIN G16      [get_ports "FMC_LPC_LA09_N"] ;# Bank  67 VCCO - VADJ_FMC - IO_L18N_T2U_N11_AD2N_67
#set_property PACKAGE_PIN D14      [get_ports "7N10403"] ;# Bank  67 VCCO - VADJ_FMC - IO_L11N_T1U_N9_GC_67
#set_property IOSTANDARD  LVCMOSxx [get_ports "7N10403"] ;# Bank  67 VCCO - VADJ_FMC - IO_L11N_T1U_N9_GC_67
#set_property PACKAGE_PIN D15      [get_ports "7N10406"] ;# Bank  67 VCCO - VADJ_FMC - IO_L11P_T1U_N8_GC_67
#set_property IOSTANDARD  LVCMOSxx [get_ports "7N10406"] ;# Bank  67 VCCO - VADJ_FMC - IO_L11P_T1U_N8_GC_67
#set_property PACKAGE_PIN F13      [get_ports "7N10612"] ;# Bank  67 VCCO - VADJ_FMC - IO_L10N_T1U_N7_QBC_AD4N_67
#set_property IOSTANDARD  LVCMOSxx [get_ports "7N10612"] ;# Bank  67 VCCO - VADJ_FMC - IO_L10N_T1U_N7_QBC_AD4N_67
#set_property PACKAGE_PIN G14      [get_ports "7N10614"] ;# Bank  67 VCCO - VADJ_FMC - IO_L10P_T1U_N6_QBC_AD4P_67
#set_property IOSTANDARD  LVCMOSxx [get_ports "7N10614"] ;# Bank  67 VCCO - VADJ_FMC - IO_L10P_T1U_N6_QBC_AD4P_67
#set_property PACKAGE_PIN E13      [get_ports "7N10207"] ;# Bank  67 VCCO - VADJ_FMC - IO_T1U_N12_67
#set_property IOSTANDARD  LVCMOSxx [get_ports "7N10207"] ;# Bank  67 VCCO - VADJ_FMC - IO_T1U_N12_67
#set_property PACKAGE_PIN C14      [get_ports "7N10204"] ;# Bank  67 VCCO - VADJ_FMC - IO_T0U_N12_VRP_67
#set_property IOSTANDARD  LVCMOSxx [get_ports "7N10204"] ;# Bank  67 VCCO - VADJ_FMC - IO_T0U_N12_VRP_67
#set_property PACKAGE_PIN C12      [get_ports "FMC_LPC_LA14_N"] ;# Bank  67 VCCO - VADJ_FMC - IO_L6N_T0U_N11_AD6N_67
#set_property PACKAGE_PIN B13      [get_ports "7N10197"] ;# Bank  67 VCCO - VADJ_FMC - IO_L4N_T0U_N7_DBC_AD7N_67
#set_property IOSTANDARD  LVCMOSxx [get_ports "7N10197"] ;# Bank  67 VCCO - VADJ_FMC - IO_L4N_T0U_N7_DBC_AD7N_67
#set_property PACKAGE_PIN B14      [get_ports "7N10198"] ;# Bank  67 VCCO - VADJ_FMC - IO_L4P_T0U_N6_DBC_AD7P_67
#set_property IOSTANDARD  LVCMOSxx [get_ports "7N10198"] ;# Bank  67 VCCO - VADJ_FMC - IO_L4P_T0U_N6_DBC_AD7P_67
#set_property PACKAGE_PIN A14      [get_ports "7N10193"] ;# Bank  67 VCCO - VADJ_FMC - IO_L3N_T0L_N5_AD15N_67
#set_property IOSTANDARD  LVCMOSxx [get_ports "7N10193"] ;# Bank  67 VCCO - VADJ_FMC - IO_L3N_T0L_N5_AD15N_67
#set_property PACKAGE_PIN A15      [get_ports "7N10194"] ;# Bank  67 VCCO - VADJ_FMC - IO_L3P_T0L_N4_AD15P_67
#set_property IOSTANDARD  LVCMOSxx [get_ports "7N10194"] ;# Bank  67 VCCO - VADJ_FMC - IO_L3P_T0L_N4_AD15P_67
#set_property PACKAGE_PIN B15      [get_ports "7N10185"] ;# Bank  67 VCCO - VADJ_FMC - IO_L2N_T0L_N3_67
#set_property IOSTANDARD  LVCMOSxx [get_ports "7N10185"] ;# Bank  67 VCCO - VADJ_FMC - IO_L2N_T0L_N3_67
#set_property PACKAGE_PIN B16      [get_ports "7N10186"] ;# Bank  67 VCCO - VADJ_FMC - IO_L2P_T0L_N2_67
#set_property IOSTANDARD  LVCMOSxx [get_ports "7N10186"] ;# Bank  67 VCCO - VADJ_FMC - IO_L2P_T0L_N2_67
#set_property PACKAGE_PIN A16      [get_ports "7N10181"] ;# Bank  67 VCCO - VADJ_FMC - IO_L1N_T0L_N1_DBC_67
#set_property IOSTANDARD  LVCMOSxx [get_ports "7N10181"] ;# Bank  67 VCCO - VADJ_FMC - IO_L1N_T0L_N1_DBC_67
#set_property PACKAGE_PIN A17      [get_ports "7N10182"] ;# Bank  67 VCCO - VADJ_FMC - IO_L1P_T0L_N0_DBC_67
#set_property IOSTANDARD  LVCMOSxx [get_ports "7N10182"] ;# Bank  67 VCCO - VADJ_FMC - IO_L1P_T0L_N0_DBC_67
#Other net   PACKAGE_PIN L18      - 7N9719                    Bank  67 - VREF_67
#set_property PACKAGE_PIN AF10     [get_ports "7N10601"] ;# Bank  66 VCCO - VCC1V2   - IO_L19N_T3L_N1_DBC_AD9N_66
#set_property IOSTANDARD  LVCMOSxx [get_ports "7N10601"] ;# Bank  66 VCCO - VCC1V2   - IO_L19N_T3L_N1_DBC_AD9N_66
#set_property PACKAGE_PIN AC14     [get_ports "7N10603"] ;# Bank  66 VCCO - VCC1V2   - IO_T3U_N12_66
#set_property IOSTANDARD  LVCMOSxx [get_ports "7N10603"] ;# Bank  66 VCCO - VCC1V2   - IO_T3U_N12_66
#set_property PACKAGE_PIN AH8      [get_ports "7N10599"] ;# Bank  66 VCCO - VCC1V2   - IO_T2U_N12_66
#set_property IOSTANDARD  LVCMOSxx [get_ports "7N10599"] ;# Bank  66 VCCO - VCC1V2   - IO_T2U_N12_66
#set_property PACKAGE_PIN AJ12     [get_ports "7N10597"] ;# Bank  66 VCCO - VCC1V2   - IO_L13N_T2L_N1_GC_QBC_66
#set_property IOSTANDARD  LVCMOSxx [get_ports "7N10597"] ;# Bank  66 VCCO - VCC1V2   - IO_L13N_T2L_N1_GC_QBC_66
#set_property PACKAGE_PIN AL13     [get_ports "7N10593"] ;# Bank  66 VCCO - VCC1V2   - IO_L7N_T1L_N1_QBC_AD13N_66
#set_property IOSTANDARD  LVCMOSxx [get_ports "7N10593"] ;# Bank  66 VCCO - VCC1V2   - IO_L7N_T1L_N1_QBC_AD13N_66
#set_property PACKAGE_PIN AM13     [get_ports "7N10595"] ;# Bank  66 VCCO - VCC1V2   - IO_T1U_N12_66
#set_property IOSTANDARD  LVCMOSxx [get_ports "7N10595"] ;# Bank  66 VCCO - VCC1V2   - IO_T1U_N12_66
#set_property PACKAGE_PIN AP8      [get_ports "VRP_66"] ;# Bank  66 VCCO - VCC1V2   - IO_T0U_N12_VRP_66
#set_property IOSTANDARD  LVCMOSxx [get_ports "VRP_66"] ;# Bank  66 VCCO - VCC1V2   - IO_T0U_N12_VRP_66
#set_property PACKAGE_PIN AP12     [get_ports "7N10591"] ;# Bank  66 VCCO - VCC1V2   - IO_L1N_T0L_N1_DBC_66
#set_property IOSTANDARD  LVCMOSxx [get_ports "7N10591"] ;# Bank  66 VCCO - VCC1V2   - IO_L1N_T0L_N1_DBC_66
#Other net   PACKAGE_PIN AB12     - 7N8282                    Bank  66 - VREF_66
#set_property PACKAGE_PIN AE19     [get_ports "6N12439"] ;# Bank  65 VCCO - VCC1V2   - IO_L19N_T3L_N1_DBC_AD9N_65
#set_property IOSTANDARD  LVCMOSxx [get_ports "6N12439"] ;# Bank  65 VCCO - VCC1V2   - IO_L19N_T3L_N1_DBC_AD9N_65
#set_property PACKAGE_PIN AE22     [get_ports "6N12442"] ;# Bank  65 VCCO - VCC1V2   - IO_T3U_N12_65
#set_property IOSTANDARD  LVCMOSxx [get_ports "6N12442"] ;# Bank  65 VCCO - VCC1V2   - IO_T3U_N12_65
#set_property PACKAGE_PIN AF20     [get_ports "6N12436"] ;# Bank  65 VCCO - VCC1V2   - IO_T2U_N12_65
#set_property IOSTANDARD  LVCMOSxx [get_ports "6N12436"] ;# Bank  65 VCCO - VCC1V2   - IO_T2U_N12_65
#set_property PACKAGE_PIN AH23     [get_ports "6N12433"] ;# Bank  65 VCCO - VCC1V2   - IO_L13N_T2L_N1_GC_QBC_65
#set_property IOSTANDARD  LVCMOSxx [get_ports "6N12433"] ;# Bank  65 VCCO - VCC1V2   - IO_L13N_T2L_N1_GC_QBC_65
#set_property PACKAGE_PIN AL21     [get_ports "6N12427"] ;# Bank  65 VCCO - VCC1V2   - IO_L7N_T1L_N1_QBC_AD13N_65
#set_property IOSTANDARD  LVCMOSxx [get_ports "6N12427"] ;# Bank  65 VCCO - VCC1V2   - IO_L7N_T1L_N1_QBC_AD13N_65
#set_property PACKAGE_PIN AH19     [get_ports "6N12430"] ;# Bank  65 VCCO - VCC1V2   - IO_T1U_N12_65
#set_property IOSTANDARD  LVCMOSxx [get_ports "6N12430"] ;# Bank  65 VCCO - VCC1V2   - IO_T1U_N12_65
#set_property PACKAGE_PIN AM20     [get_ports "VRP_65"] ;# Bank  65 VCCO - VCC1V2   - IO_T0U_N12_VRP_65
#set_property IOSTANDARD  LVCMOSxx [get_ports "VRP_65"] ;# Bank  65 VCCO - VCC1V2   - IO_T0U_N12_VRP_65
#set_property PACKAGE_PIN AP20     [get_ports "6N12401"] ;# Bank  65 VCCO - VCC1V2   - IO_L1N_T0L_N1_DBC_65
#set_property IOSTANDARD  LVCMOSxx [get_ports "6N12401"] ;# Bank  65 VCCO - VCC1V2   - IO_L1N_T0L_N1_DBC_65
#Other net   PACKAGE_PIN AB20     - 6N11582                   Bank  65 - VREF_65
#set_property PACKAGE_PIN AA17     [get_ports "6N12707"] ;# Bank  64 VCCO - VCC1V2   - IO_T3U_N12_64
#set_property IOSTANDARD  LVCMOSxx [get_ports "6N12707"] ;# Bank  64 VCCO - VCC1V2   - IO_T3U_N12_64
#set_property PACKAGE_PIN AE17     [get_ports "6N12705"] ;# Bank  64 VCCO - VCC1V2   - IO_L15P_T2L_N4_AD11P_64
#set_property IOSTANDARD  LVCMOSxx [get_ports "6N12705"] ;# Bank  64 VCCO - VCC1V2   - IO_L15P_T2L_N4_AD11P_64
#set_property PACKAGE_PIN AP14     [get_ports "VRP_64"] ;# Bank  64 VCCO - VCC1V2   - IO_T0U_N12_VRP_64
#set_property PACKAGE_PIN AP15     [get_ports "6N12788"] ;# Bank  64 VCCO - VCC1V2   - IO_L5N_T0U_N9_AD14N_64
#set_property IOSTANDARD  LVCMOSxx [get_ports "6N12788"] ;# Bank  64 VCCO - VCC1V2   - IO_L5N_T0U_N9_AD14N_64
#set_property PACKAGE_PIN AP16     [get_ports "6N12789"] ;# Bank  64 VCCO - VCC1V2   - IO_L5P_T0U_N8_AD14P_64
#set_property IOSTANDARD  LVCMOSxx [get_ports "6N12789"] ;# Bank  64 VCCO - VCC1V2   - IO_L5P_T0U_N8_AD14P_64
#set_property PACKAGE_PIN AN14     [get_ports "6N12782"] ;# Bank  64 VCCO - VCC1V2   - IO_L4N_T0U_N7_DBC_AD7N_64
#set_property IOSTANDARD  LVCMOSxx [get_ports "6N12782"] ;# Bank  64 VCCO - VCC1V2   - IO_L4N_T0U_N7_DBC_AD7N_64
#set_property PACKAGE_PIN AM14     [get_ports "6N12783"] ;# Bank  64 VCCO - VCC1V2   - IO_L4P_T0U_N6_DBC_AD7P_64
#set_property IOSTANDARD  LVCMOSxx [get_ports "6N12783"] ;# Bank  64 VCCO - VCC1V2   - IO_L4P_T0U_N6_DBC_AD7P_64
#set_property PACKAGE_PIN AN18     [get_ports "6N12780"] ;# Bank  64 VCCO - VCC1V2   - IO_L3N_T0L_N5_AD15N_64
#set_property IOSTANDARD  LVCMOSxx [get_ports "6N12780"] ;# Bank  64 VCCO - VCC1V2   - IO_L3N_T0L_N5_AD15N_64
#set_property PACKAGE_PIN AM18     [get_ports "6N12781"] ;# Bank  64 VCCO - VCC1V2   - IO_L3P_T0L_N4_AD15P_64
#set_property IOSTANDARD  LVCMOSxx [get_ports "6N12781"] ;# Bank  64 VCCO - VCC1V2   - IO_L3P_T0L_N4_AD15P_64
#set_property PACKAGE_PIN AP13     [get_ports "6N12774"] ;# Bank  64 VCCO - VCC1V2   - IO_L2N_T0L_N3_64
#set_property IOSTANDARD  LVCMOSxx [get_ports "6N12774"] ;# Bank  64 VCCO - VCC1V2   - IO_L2N_T0L_N3_64
#set_property PACKAGE_PIN AN13     [get_ports "6N12775"] ;# Bank  64 VCCO - VCC1V2   - IO_L2P_T0L_N2_64
#set_property IOSTANDARD  LVCMOSxx [get_ports "6N12775"] ;# Bank  64 VCCO - VCC1V2   - IO_L2P_T0L_N2_64
#set_property PACKAGE_PIN AP17     [get_ports "6N12772"] ;# Bank  64 VCCO - VCC1V2   - IO_L1N_T0L_N1_DBC_64
#set_property IOSTANDARD  LVCMOSxx [get_ports "6N12772"] ;# Bank  64 VCCO - VCC1V2   - IO_L1N_T0L_N1_DBC_64
#set_property PACKAGE_PIN AP18     [get_ports "6N12773"] ;# Bank  64 VCCO - VCC1V2   - IO_L1P_T0L_N0_DBC_64
#set_property IOSTANDARD  LVCMOSxxn [get_ports "6N12773"] ;# Bank  64 VCCO - VCC1V2   - IO_L1P_T0L_N0_DBC_64
#Other net   PACKAGE_PIN AG16     - 6N11370                   Bank  64 - VREF_64
#Other net   PACKAGE_PIN AD9      - MGT1V2                    Bank 224 - MGTAVTTRCAL_R
#Other net   PACKAGE_PIN A24      - MIO0_QSPI_LWR_CLK         Bank 500 - PS_MIO0
#Other net   PACKAGE_PIN C24      - MIO1_QSPI_LWR_DQ1         Bank 500 - PS_MIO1
#Other net   PACKAGE_PIN F26      - 53N7803                   Bank 500 - PS_MIO10
#Other net   PACKAGE_PIN B26      - 53N7806                   Bank 500 - PS_MIO11
#Other net   PACKAGE_PIN C27      - 53N7809                   Bank 500 - PS_MIO12
#Other net   PACKAGE_PIN D27      - 53N7788                   Bank 500 - PS_MIO13
#Other net   PACKAGE_PIN A27      - 53N7844                   Bank 500 - PS_MIO14
#Other net   PACKAGE_PIN E27      - 53N7842                   Bank 500 - PS_MIO15
#Other net   PACKAGE_PIN A28      - MIO16_I2C1_SCL            Bank 500 - PS_MIO16
#Other net   PACKAGE_PIN C29      - MIO17_I2C1_SDA            Bank 500 - PS_MIO17
#Other net   PACKAGE_PIN F27      - UART0_TXD_MIO18_RXD       Bank 500 - PS_MIO18
#Other net   PACKAGE_PIN B28      - UART0_RXD_MIO19_TXD       Bank 500 - PS_MIO19
#Other net   PACKAGE_PIN B24      - MIO2_QSPI_LWR_DQ2         Bank 500 - PS_MIO2
#Other net   PACKAGE_PIN E29      - UART1_RXD_MIO20_TXD       Bank 500 - PS_MIO20
#Other net   PACKAGE_PIN C28      - UART1_TXD_MIO21_RXD       Bank 500 - PS_MIO21
#Other net   PACKAGE_PIN F28      - 53N7824                   Bank 500 - PS_MIO22
#Other net   PACKAGE_PIN B29      - 53N7822                   Bank 500 - PS_MIO23
#Other net   PACKAGE_PIN E28      - MIO24_CAN_TX              Bank 500 - PS_MIO24
#Other net   PACKAGE_PIN D29      - MIO25_CAN_RX              Bank 500 - PS_MIO25
#Other net   PACKAGE_PIN E25      - MIO3_QSPI_LWR_DQ3         Bank 500 - PS_MIO3
#Other net   PACKAGE_PIN A25      - MIO4_QSPI_LWR_DQ0         Bank 500 - PS_MIO4
#Other net   PACKAGE_PIN D25      - MIO5_QSPI_LWR_CS_B        Bank 500 - PS_MIO5
#Other net   PACKAGE_PIN A26      - 53N6816                   Bank 500 - PS_MIO6
#Other net   PACKAGE_PIN B25      - 53N7794                   Bank 500 - PS_MIO7
#Other net   PACKAGE_PIN D26      - 53N7797                   Bank 500 - PS_MIO8
#Other net   PACKAGE_PIN C26      - 53N7800                   Bank 500 - PS_MIO9
#Other net   PACKAGE_PIN AA25     - PS_SYSMON_AVCC            Bank 500 - VCC_PSADC
#Other net   PACKAGE_PIN AA24     - PS_SYSMON_AGND            Bank 500 - GND_PSADC
#Other net   PACKAGE_PIN A29      - 53N7791                   Bank 501 - PS_MIO26
#Other net   PACKAGE_PIN A30      - MIO27_DP_AUX_OUT          Bank 501 - PS_MIO27
#Other net   PACKAGE_PIN A31      - MIO28_DP_HPD              Bank 501 - PS_MIO28
#Other net   PACKAGE_PIN A32      - MIO29_DP_OE               Bank 501 - PS_MIO29
#Other net   PACKAGE_PIN A33      - MIO30_DP_AUX_IN           Bank 501 - PS_MIO30
#Other net   PACKAGE_PIN B30      - 53N7736                   Bank 501 - PS_MIO31
#Other net   PACKAGE_PIN B31      - 53N7739                   Bank 501 - PS_MIO32
#Other net   PACKAGE_PIN B33      - 53N7742                   Bank 501 - PS_MIO33
#Other net   PACKAGE_PIN B34      - 53N7745                   Bank 501 - PS_MIO34
#Other net   PACKAGE_PIN C31      - 53N7748                   Bank 501 - PS_MIO35
#Other net   PACKAGE_PIN C32      - 53N7751                   Bank 501 - PS_MIO36
#Other net   PACKAGE_PIN C33      - 53N7754                   Bank 501 - PS_MIO37
#Other net   PACKAGE_PIN C34      - 53N7768                   Bank 501 - PS_MIO38
#Other net   PACKAGE_PIN D30      - 53N7771                   Bank 501 - PS_MIO39
#Other net   PACKAGE_PIN D31      - 53N7773                   Bank 501 - PS_MIO40
#Other net   PACKAGE_PIN D32      - 53N7775                   Bank 501 - PS_MIO41
#Other net   PACKAGE_PIN D34      - 53N7777                   Bank 501 - PS_MIO42
#Other net   PACKAGE_PIN E30      - 53N6798                   Bank 501 - PS_MIO43
#Other net   PACKAGE_PIN E32      - 53N7783                   Bank 501 - PS_MIO44
#Other net   PACKAGE_PIN E33      - MIO45_SDIO_DETECT         Bank 501 - PS_MIO45
#Other net   PACKAGE_PIN E34      - MIO46_SDIO_DAT0_R         Bank 501 - PS_MIO46
#Other net   PACKAGE_PIN F30      - MIO47_SDIO_DAT1_R         Bank 501 - PS_MIO47
#Other net   PACKAGE_PIN F31      - MIO48_SDIO_DAT2_R         Bank 501 - PS_MIO48
#Other net   PACKAGE_PIN F32      - MIO49_SDIO_DAT3_R         Bank 501 - PS_MIO49
#Other net   PACKAGE_PIN F33      - MIO50_SDIO_CMD_R          Bank 501 - PS_MIO50
#Other net   PACKAGE_PIN F34      - MIO51_SDIO_CLK_R          Bank 501 - PS_MIO51
#Other net   PACKAGE_PIN G29      - MIO52_USB_CLK             Bank 502 - PS_MIO52
#Other net   PACKAGE_PIN G30      - MIO53_USB_DIR             Bank 502 - PS_MIO53
#Other net   PACKAGE_PIN G31      - MIO54_USB_DATA2_R         Bank 502 - PS_MIO54
#Other net   PACKAGE_PIN G33      - MIO55_USB_NXT             Bank 502 - PS_MIO55
#Other net   PACKAGE_PIN G34      - MIO56_USB_DATA0_R         Bank 502 - PS_MIO56
#Other net   PACKAGE_PIN H29      - MIO57_USB_DATA1_R         Bank 502 - PS_MIO57
#Other net   PACKAGE_PIN H31      - MIO58_USB_STP_R           Bank 502 - PS_MIO58
#Other net   PACKAGE_PIN H32      - MIO59_USB_DATA3_R         Bank 502 - PS_MIO59
#Other net   PACKAGE_PIN H33      - MIO60_USB_DATA4_R         Bank 502 - PS_MIO60
#Other net   PACKAGE_PIN H34      - MIO61_USB_DATA5_R         Bank 502 - PS_MIO61
#Other net   PACKAGE_PIN J29      - MIO62_USB_DATA6_R         Bank 502 - PS_MIO62
#Other net   PACKAGE_PIN J30      - MIO63_USB_DATA7_R         Bank 502 - PS_MIO63
#Other net   PACKAGE_PIN J31      - MIO64_ENET_TX_CLK         Bank 502 - PS_MIO64
#Other net   PACKAGE_PIN J32      - MIO65_ENET_TX_D0          Bank 502 - PS_MIO65
#Other net   PACKAGE_PIN J34      - MIO66_ENET_TX_D1          Bank 502 - PS_MIO66
#Other net   PACKAGE_PIN K28      - MIO67_ENET_TX_D2          Bank 502 - PS_MIO67
#Other net   PACKAGE_PIN K29      - MIO68_ENET_TX_D3          Bank 502 - PS_MIO68
#Other net   PACKAGE_PIN K30      - MIO69_ENET_TX_CTRL        Bank 502 - PS_MIO69
#Other net   PACKAGE_PIN K31      - MIO70_ENET_RX_CLK         Bank 502 - PS_MIO70
#Other net   PACKAGE_PIN K32      - MIO71_ENET_RX_D0          Bank 502 - PS_MIO71
#Other net   PACKAGE_PIN K33      - MIO72_ENET_RX_D1          Bank 502 - PS_MIO72
#Other net   PACKAGE_PIN K34      - MIO73_ENET_RX_D2          Bank 502 - PS_MIO73
#Other net   PACKAGE_PIN L29      - MIO74_ENET_RX_D3          Bank 502 - PS_MIO74
#Other net   PACKAGE_PIN L30      - MIO75_ENET_RX_CTRL        Bank 502 - PS_MIO75
#Other net   PACKAGE_PIN L33      - MIO76_ENET_MDC            Bank 502 - PS_MIO76
#Other net   PACKAGE_PIN L34      - MIO77_ENET_MDIO           Bank 502 - PS_MIO77
#Other net   PACKAGE_PIN N24      - PS_DONE                   Bank 503 - PS_DONE
#Other net   PACKAGE_PIN T25      - PS_ERR_OUT                Bank 503 - PS_ERROR_OUT
#Other net   PACKAGE_PIN R25      - PS_ERR_STATUS             Bank 503 - PS_ERROR_STATUS
#Other net   PACKAGE_PIN P24      - PS_INIT_B                 Bank 503 - PS_INIT_B
#Other net   PACKAGE_PIN K27      - FPGA_TCK                  Bank 503 - PS_JTAG_TCK
#Other net   PACKAGE_PIN J27      - FPGA_TDI                  Bank 503 - PS_JTAG_TDI
#Other net   PACKAGE_PIN G28      - FPGA_TDO_FMC_TDI          Bank 503 - PS_JTAG_TDO
#Other net   PACKAGE_PIN H28      - FPGA_TMS                  Bank 503 - PS_JTAG_TMS
#Other net   PACKAGE_PIN H27      - PS_MODE0                  Bank 503 - PS_MODE0
#Other net   PACKAGE_PIN J26      - PS_MODE1                  Bank 503 - PS_MODE1
#Other net   PACKAGE_PIN K26      - PS_MODE2                  Bank 503 - PS_MODE2
#Other net   PACKAGE_PIN K25      - PS_MODE3                  Bank 503 - PS_MODE3
#Other net   PACKAGE_PIN M25      - PS_PADI                   Bank 503 - PS_PADI
#Other net   PACKAGE_PIN L25      - PS_PADO                   Bank 503 - PS_PADO
#Other net   PACKAGE_PIN M24      - PS_POR_B                  Bank 503 - PS_POR_B
#Other net   PACKAGE_PIN T24      - PS_PROG_B                 Bank 503 - PS_PROG_B
#Other net   PACKAGE_PIN R24      - PS_REF_CLK                Bank 503 - PS_REF_CLK
#Other net   PACKAGE_PIN P25      - PS_SRST_B                 Bank 503 - PS_SRST_B
#Other net   PACKAGE_PIN AN34     - DDR4_A0                   Bank 504 - PS_DDR_A0
#Other net   PACKAGE_PIN AM34     - DDR4_A1                   Bank 504 - PS_DDR_A1
#Other net   PACKAGE_PIN AG31     - DDR4_A10                  Bank 504 - PS_DDR_A10
#Other net   PACKAGE_PIN AF31     - DDR4_A11                  Bank 504 - PS_DDR_A11
#Other net   PACKAGE_PIN AG30     - DDR4_A12                  Bank 504 - PS_DDR_A12
#Other net   PACKAGE_PIN AF30     - DDR4_A13                  Bank 504 - PS_DDR_A13
#Other net   PACKAGE_PIN AG29     - DDR4_A14_WE_B             Bank 504 - PS_DDR_A14
#Other net   PACKAGE_PIN AG28     - DDR4_A15_CAS_B            Bank 504 - PS_DDR_A15
#Other net   PACKAGE_PIN AF28     - DDR4_A16_RAS_B            Bank 504 - PS_DDR_A16
#Other net   PACKAGE_PIN AF26     - 68N6692                   Bank 504 - PS_DDR_A17
#Other net   PACKAGE_PIN AM33     - DDR4_A2                   Bank 504 - PS_DDR_A2
#Other net   PACKAGE_PIN AL34     - DDR4_A3                   Bank 504 - PS_DDR_A3
#Other net   PACKAGE_PIN AL33     - DDR4_A4                   Bank 504 - PS_DDR_A4
#Other net   PACKAGE_PIN AK33     - DDR4_A5                   Bank 504 - PS_DDR_A5
#Other net   PACKAGE_PIN AK30     - DDR4_A6                   Bank 504 - PS_DDR_A6
#Other net   PACKAGE_PIN AJ30     - DDR4_A7                   Bank 504 - PS_DDR_A7
#Other net   PACKAGE_PIN AJ31     - DDR4_A8                   Bank 504 - PS_DDR_A8
#Other net   PACKAGE_PIN AH31     - DDR4_A9                   Bank 504 - PS_DDR_A9
#Other net   PACKAGE_PIN AE25     - DDR4_ACT_B                Bank 504 - PS_DDR_ACT_N
#Other net   PACKAGE_PIN AB26     - DDR4_ALERT_B              Bank 504 - PS_DDR_ALERT_N
#Other net   PACKAGE_PIN AE27     - DDR4_BA0                  Bank 504 - PS_DDR_BA0
#Other net   PACKAGE_PIN AE28     - DDR4_BA1                  Bank 504 - PS_DDR_BA1
#Other net   PACKAGE_PIN AD27     - DDR4_BG0                  Bank 504 - PS_DDR_BG0
#Other net   PACKAGE_PIN AF27     - 68N7393                   Bank 504 - PS_DDR_BG1
#Other net   PACKAGE_PIN AL31     - DDR4_CK_T                 Bank 504 - PS_DDR_CK0
#Other net   PACKAGE_PIN AL30     - 68N7399                   Bank 504 - PS_DDR_CK1
#Other net   PACKAGE_PIN AN33     - DDR4_CKE                  Bank 504 - PS_DDR_CKE0
#Other net   PACKAGE_PIN AH32     - 68N7405                   Bank 504 - PS_DDR_CKE1
#Other net   PACKAGE_PIN AN32     - DDR4_CK_C                 Bank 504 - PS_DDR_CK_N0
#Other net   PACKAGE_PIN AL32     - 68N7402                   Bank 504 - PS_DDR_CK_N1
#Other net   PACKAGE_PIN AP33     - DDR4_CS_B                 Bank 504 - PS_DDR_CS_N0
#Other net   PACKAGE_PIN AK32     - 68N7396                   Bank 504 - PS_DDR_CS_N1
#Other net   PACKAGE_PIN AN24     - DDR4_DM0                  Bank 504 - PS_DDR_DM0
#Other net   PACKAGE_PIN AM29     - DDR4_DM1                  Bank 504 - PS_DDR_DM1
#Other net   PACKAGE_PIN AH24     - DDR4_DM2                  Bank 504 - PS_DDR_DM2
#Other net   PACKAGE_PIN AJ29     - DDR4_DM3                  Bank 504 - PS_DDR_DM3
#Other net   PACKAGE_PIN AD29     - DDR4_DM4                  Bank 504 - PS_DDR_DM4
#Other net   PACKAGE_PIN Y29      - DDR4_DM5                  Bank 504 - PS_DDR_DM5
#Other net   PACKAGE_PIN AC32     - DDR4_DM6                  Bank 504 - PS_DDR_DM6
#Other net   PACKAGE_PIN Y32      - DDR4_DM7                  Bank 504 - PS_DDR_DM7
#Other net   PACKAGE_PIN AF34     - 68N7353                   Bank 504 - PS_DDR_DM8
#Other net   PACKAGE_PIN AP27     - DDR4_DQ0                  Bank 504 - PS_DDR_DQ0
#Other net   PACKAGE_PIN AP25     - DDR4_DQ1                  Bank 504 - PS_DDR_DQ1
#Other net   PACKAGE_PIN AP29     - DDR4_DQ10                 Bank 504 - PS_DDR_DQ10
#Other net   PACKAGE_PIN AP28     - DDR4_DQ11                 Bank 504 - PS_DDR_DQ11
#Other net   PACKAGE_PIN AM31     - DDR4_DQ12                 Bank 504 - PS_DDR_DQ12
#Other net   PACKAGE_PIN AP31     - DDR4_DQ13                 Bank 504 - PS_DDR_DQ13
#Other net   PACKAGE_PIN AN31     - DDR4_DQ14                 Bank 504 - PS_DDR_DQ14
#Other net   PACKAGE_PIN AM30     - DDR4_DQ15                 Bank 504 - PS_DDR_DQ15
#Other net   PACKAGE_PIN AF25     - DDR4_DQ16                 Bank 504 - PS_DDR_DQ16
#Other net   PACKAGE_PIN AG25     - DDR4_DQ17                 Bank 504 - PS_DDR_DQ17
#Other net   PACKAGE_PIN AG26     - DDR4_DQ18                 Bank 504 - PS_DDR_DQ18
#Other net   PACKAGE_PIN AJ25     - DDR4_DQ19                 Bank 504 - PS_DDR_DQ19
#Other net   PACKAGE_PIN AP26     - DDR4_DQ2                  Bank 504 - PS_DDR_DQ2
#Other net   PACKAGE_PIN AG24     - DDR4_DQ20                 Bank 504 - PS_DDR_DQ20
#Other net   PACKAGE_PIN AK25     - DDR4_DQ21                 Bank 504 - PS_DDR_DQ21
#Other net   PACKAGE_PIN AJ24     - DDR4_DQ22                 Bank 504 - PS_DDR_DQ22
#Other net   PACKAGE_PIN AK24     - DDR4_DQ23                 Bank 504 - PS_DDR_DQ23
#Other net   PACKAGE_PIN AH28     - DDR4_DQ24                 Bank 504 - PS_DDR_DQ24
#Other net   PACKAGE_PIN AH27     - DDR4_DQ25                 Bank 504 - PS_DDR_DQ25
#Other net   PACKAGE_PIN AJ27     - DDR4_DQ26                 Bank 504 - PS_DDR_DQ26
#Other net   PACKAGE_PIN AK27     - DDR4_DQ27                 Bank 504 - PS_DDR_DQ27
#Other net   PACKAGE_PIN AL26     - DDR4_DQ28                 Bank 504 - PS_DDR_DQ28
#Other net   PACKAGE_PIN AL27     - DDR4_DQ29                 Bank 504 - PS_DDR_DQ29
#Other net   PACKAGE_PIN AM26     - DDR4_DQ3                  Bank 504 - PS_DDR_DQ3
#Other net   PACKAGE_PIN AH29     - DDR4_DQ30                 Bank 504 - PS_DDR_DQ30
#Other net   PACKAGE_PIN AL28     - DDR4_DQ31                 Bank 504 - PS_DDR_DQ31
#Other net   PACKAGE_PIN AB29     - DDR4_DQ32                 Bank 504 - PS_DDR_DQ32
#Other net   PACKAGE_PIN AB30     - DDR4_DQ33                 Bank 504 - PS_DDR_DQ33
#Other net   PACKAGE_PIN AC29     - DDR4_DQ34                 Bank 504 - PS_DDR_DQ34
#Other net   PACKAGE_PIN AD32     - DDR4_DQ35                 Bank 504 - PS_DDR_DQ35
#Other net   PACKAGE_PIN AC31     - DDR4_DQ36                 Bank 504 - PS_DDR_DQ36
#Other net   PACKAGE_PIN AE30     - DDR4_DQ37                 Bank 504 - PS_DDR_DQ37
#Other net   PACKAGE_PIN AC28     - DDR4_DQ38                 Bank 504 - PS_DDR_DQ38
#Other net   PACKAGE_PIN AE29     - DDR4_DQ39                 Bank 504 - PS_DDR_DQ39
#Other net   PACKAGE_PIN AP24     - DDR4_DQ4                  Bank 504 - PS_DDR_DQ4
#Other net   PACKAGE_PIN AC27     - DDR4_DQ40                 Bank 504 - PS_DDR_DQ40
#Other net   PACKAGE_PIN AA27     - DDR4_DQ41                 Bank 504 - PS_DDR_DQ41
#Other net   PACKAGE_PIN AA28     - DDR4_DQ42                 Bank 504 - PS_DDR_DQ42
#Other net   PACKAGE_PIN AB28     - DDR4_DQ43                 Bank 504 - PS_DDR_DQ43
#Other net   PACKAGE_PIN W27      - DDR4_DQ44                 Bank 504 - PS_DDR_DQ44
#Other net   PACKAGE_PIN W29      - DDR4_DQ45                 Bank 504 - PS_DDR_DQ45
#Other net   PACKAGE_PIN W28      - DDR4_DQ46                 Bank 504 - PS_DDR_DQ46
#Other net   PACKAGE_PIN V27      - DDR4_DQ47                 Bank 504 - PS_DDR_DQ47
#Other net   PACKAGE_PIN AA32     - DDR4_DQ48                 Bank 504 - PS_DDR_DQ48
#Other net   PACKAGE_PIN AA33     - DDR4_DQ49                 Bank 504 - PS_DDR_DQ49
#Other net   PACKAGE_PIN AL25     - DDR4_DQ5                  Bank 504 - PS_DDR_DQ5
#Other net   PACKAGE_PIN AA34     - DDR4_DQ50                 Bank 504 - PS_DDR_DQ50
#Other net   PACKAGE_PIN AE34     - DDR4_DQ51                 Bank 504 - PS_DDR_DQ51
#Other net   PACKAGE_PIN AD34     - DDR4_DQ52                 Bank 504 - PS_DDR_DQ52
#Other net   PACKAGE_PIN AB31     - DDR4_DQ53                 Bank 504 - PS_DDR_DQ53
#Other net   PACKAGE_PIN AC34     - DDR4_DQ54                 Bank 504 - PS_DDR_DQ54
#Other net   PACKAGE_PIN AC33     - DDR4_DQ55                 Bank 504 - PS_DDR_DQ55
#Other net   PACKAGE_PIN AA30     - DDR4_DQ56                 Bank 504 - PS_DDR_DQ56
#Other net   PACKAGE_PIN Y30      - DDR4_DQ57                 Bank 504 - PS_DDR_DQ57
#Other net   PACKAGE_PIN AA31     - DDR4_DQ58                 Bank 504 - PS_DDR_DQ58
#Other net   PACKAGE_PIN W30      - DDR4_DQ59                 Bank 504 - PS_DDR_DQ59
#Other net   PACKAGE_PIN AM25     - DDR4_DQ6                  Bank 504 - PS_DDR_DQ6
#Other net   PACKAGE_PIN Y33      - DDR4_DQ60                 Bank 504 - PS_DDR_DQ60
#Other net   PACKAGE_PIN W33      - DDR4_DQ61                 Bank 504 - PS_DDR_DQ61
#Other net   PACKAGE_PIN W34      - DDR4_DQ62                 Bank 504 - PS_DDR_DQ62
#Other net   PACKAGE_PIN Y34      - DDR4_DQ63                 Bank 504 - PS_DDR_DQ63
#Other net   PACKAGE_PIN AF32     - 68N7356                   Bank 504 - PS_DDR_DQ64
#Other net   PACKAGE_PIN AE32     - 68N7359                   Bank 504 - PS_DDR_DQ65
#Other net   PACKAGE_PIN AH33     - 68N7362                   Bank 504 - PS_DDR_DQ66
#Other net   PACKAGE_PIN AE33     - 68N7364                   Bank 504 - PS_DDR_DQ67
#Other net   PACKAGE_PIN AF33     - 68N7368                   Bank 504 - PS_DDR_DQ68
#Other net   PACKAGE_PIN AH34     - 68N7370                   Bank 504 - PS_DDR_DQ69
#Other net   PACKAGE_PIN AM24     - DDR4_DQ7                  Bank 504 - PS_DDR_DQ7
#Other net   PACKAGE_PIN AJ34     - 68N7374                   Bank 504 - PS_DDR_DQ70
#Other net   PACKAGE_PIN AK34     - 68N7376                   Bank 504 - PS_DDR_DQ71
#Other net   PACKAGE_PIN AM28     - DDR4_DQ8                  Bank 504 - PS_DDR_DQ8
#Other net   PACKAGE_PIN AN28     - DDR4_DQ9                  Bank 504 - PS_DDR_DQ9
#Other net   PACKAGE_PIN AN27     - DDR4_DQS0_C               Bank 504 - PS_DDR_DQS_N0
#Other net   PACKAGE_PIN AP30     - DDR4_DQS1_C               Bank 504 - PS_DDR_DQS_N1
#Other net   PACKAGE_PIN AJ26     - DDR4_DQS2_C               Bank 504 - PS_DDR_DQS_N2
#Other net   PACKAGE_PIN AK29     - DDR4_DQS3_C               Bank 504 - PS_DDR_DQS_N3
#Other net   PACKAGE_PIN AD31     - DDR4_DQS4_C               Bank 504 - PS_DDR_DQS_N4
#Other net   PACKAGE_PIN Y28      - DDR4_DQS5_C               Bank 504 - PS_DDR_DQS_N5
#Other net   PACKAGE_PIN AB34     - DDR4_DQS6_C               Bank 504 - PS_DDR_DQS_N6
#Other net   PACKAGE_PIN W32      - DDR4_DQS7_C               Bank 504 - PS_DDR_DQS_N7
#Other net   PACKAGE_PIN AG34     - 68N7350                   Bank 504 - PS_DDR_DQS_N8
#Other net   PACKAGE_PIN AN26     - DDR4_DQS0_T               Bank 504 - PS_DDR_DQS_P0
#Other net   PACKAGE_PIN AN29     - DDR4_DQS1_T               Bank 504 - PS_DDR_DQS_P1
#Other net   PACKAGE_PIN AH26     - DDR4_DQS2_T               Bank 504 - PS_DDR_DQS_P2
#Other net   PACKAGE_PIN AK28     - DDR4_DQS3_T               Bank 504 - PS_DDR_DQS_P3
#Other net   PACKAGE_PIN AD30     - DDR4_DQS4_T               Bank 504 - PS_DDR_DQS_P4
#Other net   PACKAGE_PIN Y27      - DDR4_DQS5_T               Bank 504 - PS_DDR_DQS_P5
#Other net   PACKAGE_PIN AB33     - DDR4_DQS6_T               Bank 504 - PS_DDR_DQS_P6
#Other net   PACKAGE_PIN W31      - DDR4_DQS7_T               Bank 504 - PS_DDR_DQS_P7
#Other net   PACKAGE_PIN AG33     - 68N7347                   Bank 504 - PS_DDR_DQS_P8
#Other net   PACKAGE_PIN AP32     - DDR4_ODT                  Bank 504 - PS_DDR_ODT0
#Other net   PACKAGE_PIN AJ32     - 68N7408                   Bank 504 - PS_DDR_ODT1
#Other net   PACKAGE_PIN AA26     - DDR4_PAR                  Bank 504 - PS_DDR_PARITY
#Other net   PACKAGE_PIN AD26     - DDR4_RESET_B              Bank 504 - PS_DDR_RAM_RST_N
#Other net   PACKAGE_PIN AC26     - SODIMM_ZQ                 Bank 504 - PS_DDR_ZQ
#Other net   PACKAGE_PIN U34      - 69N6524                   Bank 505 - PS_MGTRRXN0_505
#Other net   PACKAGE_PIN T32      - 69N6530                   Bank 505 - PS_MGTRRXN1_505
#Other net   PACKAGE_PIN R34      - GT2_USB0_RX_N             Bank 505 - PS_MGTRRXN2_505
#Other net   PACKAGE_PIN N34      - GT3_SATA1_RX_N            Bank 505 - PS_MGTRRXN3_505
#Other net   PACKAGE_PIN U33      - 69N6521                   Bank 505 - PS_MGTRRXP0_505
#Other net   PACKAGE_PIN T31      - 69N6527                   Bank 505 - PS_MGTRRXP1_505
#Other net   PACKAGE_PIN R33      - GT2_USB0_RX_P             Bank 505 - PS_MGTRRXP2_505
#Other net   PACKAGE_PIN N33      - GT3_SATA1_RX_P            Bank 505 - PS_MGTRRXP3_505
#Other net   PACKAGE_PIN U30      - GT0_DP_TX_N               Bank 505 - PS_MGTRTXN0_505
#Other net   PACKAGE_PIN R30      - GT1_DP_TX_N               Bank 505 - PS_MGTRTXN1_505
#Other net   PACKAGE_PIN P32      - GT2_USB0_TX_N             Bank 505 - PS_MGTRTXN2_505
#Other net   PACKAGE_PIN N30      - GT3_SATA1_TX_N            Bank 505 - PS_MGTRTXN3_505
#Other net   PACKAGE_PIN U29      - GT0_DP_TX_P               Bank 505 - PS_MGTRTXP0_505
#Other net   PACKAGE_PIN R29      - GT1_DP_TX_P               Bank 505 - PS_MGTRTXP1_505
#Other net   PACKAGE_PIN P31      - GT2_USB0_TX_P             Bank 505 - PS_MGTRTXP2_505
#Other net   PACKAGE_PIN N29      - GT3_SATA1_TX_P            Bank 505 - PS_MGTRTXP3_505
#Other net   PACKAGE_PIN T28      - 69N6536                   Bank 505 - PS_MGTREFCLK0N_505
#Other net   PACKAGE_PIN T27      - 69N6533                   Bank 505 - PS_MGTREFCLK0P_505
#Other net   PACKAGE_PIN P28      - GTR_REF_CLK_SATA_C_N      Bank 505 - PS_MGTREFCLK1N_505
#Other net   PACKAGE_PIN P27      - GTR_REF_CLK_SATA_C_P      Bank 505 - PS_MGTREFCLK1P_505
#Other net   PACKAGE_PIN M28      - GTR_REF_CLK_USB3_C_N      Bank 505 - PS_MGTREFCLK2N_505
#Other net   PACKAGE_PIN M27      - GTR_REF_CLK_USB3_C_P      Bank 505 - PS_MGTREFCLK2P_505
#Other net   PACKAGE_PIN M32      - GTR_REF_CLK_DP_C_N        Bank 505 - PS_MGTREFCLK3N_505
#Other net   PACKAGE_PIN M31      - GTR_REF_CLK_DP_C_P        Bank 505 - PS_MGTREFCLK3P_505
#Other net   PACKAGE_PIN U31      - 69N5804                   Bank 505 - PS_MGTRREF_505
#Other net   PACKAGE_PIN AE16     - VCC1V2                    Bank  64 - VCCO_64
#Other net   PACKAGE_PIN AH15     - VCC1V2                    Bank  64 - VCCO_64
#Other net   PACKAGE_PIN AJ18     - VCC1V2                    Bank  64 - VCCO_64
#Other net   PACKAGE_PIN AF19     - VCC1V2                    Bank  65 - VCCO_65
#Other net   PACKAGE_PIN AG22     - VCC1V2                    Bank  65 - VCCO_65
#Other net   PACKAGE_PIN AK21     - VCC1V2                    Bank  65 - VCCO_65
#Other net   PACKAGE_PIN AF9      - VCC1V2                    Bank  66 - VCCO_66
#Other net   PACKAGE_PIN AG12     - VCC1V2                    Bank  66 - VCCO_66
#Other net   PACKAGE_PIN AK11     - VCC1V2                    Bank  66 - VCCO_66
#Other net   PACKAGE_PIN E21      - VCC1V8                    Bank  28 - VCCO_28
#Other net   PACKAGE_PIN F24      - VCC1V8                    Bank  28 - VCCO_28
#Other net   PACKAGE_PIN H20      - VCC1V8                    Bank  28 - VCCO_28
#Other net   PACKAGE_PIN D13      - VADJ_FMC                  Bank  67 - VCCO_67
#Other net   PACKAGE_PIN E16      - VADJ_FMC                  Bank  67 - VCCO_67
#Other net   PACKAGE_PIN H15      - VADJ_FMC                  Bank  67 - VCCO_67
#Other net   PACKAGE_PIN F9       - VADJ_FMC                  Bank  68 - VCCO_68
#Other net   PACKAGE_PIN G12      - VADJ_FMC                  Bank  68 - VCCO_68
#Other net   PACKAGE_PIN K11      - VADJ_FMC                  Bank  68 - VCCO_68
#Other net   PACKAGE_PIN J8       - VCC3V3                    Bank  87 - VCCO_87
#Other net   PACKAGE_PIN N10      - VCC3V3                    Bank  87 - VCCO_87
#Other net   PACKAGE_PIN D3       - VCC3V3                    Bank  88 - VCCO_88
#Other net   PACKAGE_PIN E6       - VCC3V3                    Bank  88 - VCCO_88
#Other net   PACKAGE_PIN C25      - VCC1V8                    Bank 500 - VCCO_PSIO0_500
#Other net   PACKAGE_PIN D28      - VCC1V8                    Bank 500 - VCCO_PSIO0_500
#Other net   PACKAGE_PIN B32      - VCC1V8                    Bank 501 - VCCO_PSIO1_501
#Other net   PACKAGE_PIN E31      - VCC1V8                    Bank 501 - VCCO_PSIO1_501
#Other net   PACKAGE_PIN H30      - VCC1V8                    Bank 502 - VCCO_PSIO2_502
#Other net   PACKAGE_PIN J33      - VCC1V8                    Bank 502 - VCCO_PSIO2_502
#Other net   PACKAGE_PIN G27      - VCC1V8                    Bank 503 - VCCO_PSIO3_503
#Other net   PACKAGE_PIN N25      - VCC1V8                    Bank 503 - VCCO_PSIO3_503
#Other net   PACKAGE_PIN AE26     - VCC1V2                    Bank 504 - VCCO_PSDDR_504
#Other net   PACKAGE_PIN AE31     - VCC1V2                    Bank 504 - VCCO_PSDDR_504
#Other net   PACKAGE_PIN AG27     - VCC1V2                    Bank 504 - VCCO_PSDDR_504
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
#Other net   PACKAGE_PIN AD22     - VCCINT_VCU                Bank 999 - VCCINT_VCU
#Other net   PACKAGE_PIN AD23     - VCCINT_VCU                Bank 999 - VCCINT_VCU
#Other net   PACKAGE_PIN AD24     - VCCINT_VCU                Bank 999 - VCCINT_VCU

set_property IOSTANDARD LVCMOS33 [get_ports PMOD0_0]
set_property IOSTANDARD LVCMOS33 [get_ports PMOD0_1]
set_property IOSTANDARD LVCMOS33 [get_ports PMOD0_2]
set_property IOSTANDARD LVCMOS33 [get_ports PMOD0_3]
set_property IOSTANDARD LVCMOS33 [get_ports PMOD0_4]
set_property IOSTANDARD LVCMOS33 [get_ports PMOD0_5]
set_property IOSTANDARD LVCMOS33 [get_ports PMOD0_6]
set_property IOSTANDARD LVCMOS33 [get_ports PMOD0_7]
set_property PACKAGE_PIN G8 [get_ports PMOD0_0]
set_property PACKAGE_PIN H8 [get_ports PMOD0_1]
set_property PACKAGE_PIN G7 [get_ports PMOD0_2]
set_property PACKAGE_PIN H7 [get_ports PMOD0_3]
set_property PACKAGE_PIN G6 [get_ports PMOD0_4]
set_property PACKAGE_PIN H6 [get_ports PMOD0_5]
set_property PACKAGE_PIN J6 [get_ports PMOD0_6]
set_property PACKAGE_PIN J7 [get_ports PMOD0_7]
set_property PULLDOWN true [get_ports PMOD0_0]
set_property PULLDOWN true [get_ports PMOD0_1]
set_property PULLUP true [get_ports PMOD0_2]
set_property PULLUP true [get_ports PMOD0_3]
set_property PULLUP true [get_ports PMOD0_4]
set_property PULLUP true [get_ports PMOD0_5]
set_property PULLUP true [get_ports PMOD0_6]
set_property PULLUP true [get_ports PMOD0_7]

##set_property CLOCK_DEDICATED_ROUTE FALSE [get_nets PMOD0_7_IBUF_inst/O]

#set_property IOSTANDARD LVCMOS33 [get_ports PMOD1_0]
#set_property IOSTANDARD LVCMOS33 [get_ports PMOD1_1]
#set_property IOSTANDARD LVCMOS33 [get_ports PMOD1_2]
#set_property IOSTANDARD LVCMOS33 [get_ports PMOD1_3]
#set_property IOSTANDARD LVCMOS33 [get_ports PMOD1_4]
#set_property IOSTANDARD LVCMOS33 [get_ports PMOD1_5]
#set_property IOSTANDARD LVCMOS33 [get_ports PMOD1_6]
#set_property IOSTANDARD LVCMOS33 [get_ports PMOD1_7]
#set_property PACKAGE_PIN J9  [get_ports PMOD1_0]
#set_property PACKAGE_PIN K9  [get_ports PMOD1_1]
#set_property PACKAGE_PIN K8  [get_ports PMOD1_2]
#set_property PACKAGE_PIN L8  [get_ports PMOD1_3]
#set_property PACKAGE_PIN L10 [get_ports PMOD1_4]
#set_property PACKAGE_PIN M10 [get_ports PMOD1_5]
#set_property PACKAGE_PIN M8  [get_ports PMOD1_6]
#set_property PACKAGE_PIN M9  [get_ports PMOD1_7]

#set_property PULLUP true [get_ports PMOD1_7]
#set_property PULLUP true [get_ports PMOD1_6]
#set_property PULLUP true [get_ports PMOD1_5]
#set_property PULLUP true [get_ports PMOD1_4]
#set_property PULLUP true [get_ports PMOD1_3]
#set_property PULLUP true [get_ports PMOD1_2]
#set_property PULLUP true [get_ports PMOD1_1]
#set_property PULLUP true [get_ports PMOD1_0]


#PMODA pin0 to FTCLK
#set_property PACKAGE_PIN K9 [get_ports {P1[1]}]

#PMODA pin1 to FTSSN
#set_property PACKAGE_PIN L8 [get_ports {P1[3]}]

#PMODA pin2 to FTMISO
#set_property PACKAGE_PIN J9 [get_ports {P1[0]}]

#PMODA pin3 to FTMIOSIO
#set_property PACKAGE_PIN K8 [get_ports {P1[2]}]

#PMODB pin1 to SWDIOTMS
#set_property PACKAGE_PIN G8 [get_ports SWDIOTMS]

#PMODB pin4 to SWCLKTCK
#set_property PACKAGE_PIN H7 [get_ports SWCLKTCK]
#set_property CLOCK_DEDICATED_ROUTE FALSE [get_nets uPAD_SWDCLK_I/IOBUF3V3/O]

#PMODA pin4 : UART2RXD
#PMODA pin4 : UART2TXD


# LED0 to P0[0]
#set_property PACKAGE_PIN D5 [get_ports {P0[0]}]
# LED1 to P0[1]
#set_property PACKAGE_PIN D6 [get_ports {P0[1]}]
# LED2 to P0[2]
#set_property PACKAGE_PIN A5 [get_ports {P0[2]}]
# LED3 to P0[3]
#set_property PACKAGE_PIN B5 [get_ports {P0[3]}]

# SW0 to NRST (Down for active low)
#set_property PACKAGE_PIN B4 [get_ports NRST]

# CLK125MHz (need dvider)
#set_property IOSTANDARD LVCMOS18 [get_ports XTAL1 ]
#set_property PACKAGE_PIN F23 [get_ports XTAL1]


## auto mapped - to remap
#set_property PACKAGE_PIN C4 [get_ports {P0[10]}]
#set_property PACKAGE_PIN C3 [get_ports {P0[11]}]
#set_property PACKAGE_PIN B3 [get_ports {P0[12]}]
#set_property PACKAGE_PIN D2 [get_ports {P0[13]}]
#set_property PACKAGE_PIN C2 [get_ports {P0[14]}]
#set_property PACKAGE_PIN E3 [get_ports {P0[15]}]
#set_property PACKAGE_PIN F6 [get_ports {P0[4]}]
#set_property PACKAGE_PIN E5 [get_ports {P0[5]}]
#set_property PACKAGE_PIN F5 [get_ports {P0[6]}]
#set_property PACKAGE_PIN F4 [get_ports {P0[7]}]
#set_property PACKAGE_PIN E4 [get_ports {P0[8]}]
#set_property PACKAGE_PIN D4 [get_ports {P0[9]}]
#set_property PACKAGE_PIN M10 [get_ports {P1[10]}]
#set_property PACKAGE_PIN L10 [get_ports {P1[11]}]
#set_property PACKAGE_PIN M9 [get_ports {P1[12]}]
#set_property PACKAGE_PIN M8 [get_ports {P1[13]}]
#set_property PACKAGE_PIN N11 [get_ports {P1[14]}]
#set_property PACKAGE_PIN M11 [get_ports {P1[15]}]
#set_property PACKAGE_PIN H8 [get_ports {P1[4]}]
#set_property PACKAGE_PIN G7 [get_ports {P1[5]}]
#set_property PACKAGE_PIN H6 [get_ports {P1[6]}]
#set_property PACKAGE_PIN G6 [get_ports {P1[7]}]
#set_property PACKAGE_PIN J7 [get_ports {P1[8]}]
#set_property PACKAGE_PIN J6 [get_ports {P1[9]}]
#set_property PACKAGE_PIN E2 [get_ports VDD]
#set_property PACKAGE_PIN A3 [get_ports VDDIO]
#set_property PACKAGE_PIN A2 [get_ports VSS]
#set_property PACKAGE_PIN C1 [get_ports VSSIO]
#set_property PACKAGE_PIN B1 [get_ports XTAL2]
