lewisMW/agriculture-SoC/software/hello/read_entire_fifo.c

/*
/*
 *-----------------------------------------------------------------------------
 * The confidential and proprietary information contained in this file may
 * only be used by a person authorised under and to the extent permitted
 * by a subsisting licensing agreement from ARM Limited or its affiliates.
 *
 *            (C) COPYRIGHT 2010-2013 ARM Limited or its affiliates.
 *                ALL RIGHTS RESERVED
 *
 * This entire notice must be reproduced on all copies of this file
 * and copies of this file may only be made by a person if such person is
 * permitted to do so under the terms of a subsisting license agreement
 * from ARM Limited or its affiliates.
 *
 *      SVN Information
 *
 *      Checked In          : $Date: 2017-07-25 15:10:13 +0100 (Tue, 25 Jul 2017) $
 *
 *      Revision            : $Revision: 368444 $
 *
 *      Release Information : Cortex-M0 DesignStart-r2p0-00rel0
 *-----------------------------------------------------------------------------
 */

#ifdef CORTEX_M0
#include "CMSDK_CM0.h"
#include "core_cm0.h"
#endif

#ifdef CORTEX_M0PLUS
#include "CMSDK_CM0plus.h"
#include "core_cm0plus.h"
#endif

#include <stdio.h>
#include <inttypes.h>

#define FIFO_STATUS_MASK 0b11

volatile unsigned int get_fifo_status(volatile unsigned int *APB_BUS_ADDR);
uint64_t get_FIFO_value(volatile unsigned int* FIFO_MEASUREMENT_ADDR);

// This test is complicated: It has function calls and tests repeatedly reading from a full fifo.
int main (void)
{
    // Pointer to GPIO register from memory map
    // volatile unsigned int *GPIO_DATA = (unsigned int *)0x50000000;
    //Pointer to APB Bus from memory map 
    // TODO Check where it is.
    volatile unsigned int *APB_BUS = (unsigned int *)0x51000000;

    // Read the status register.
    volatile unsigned int *STATUS_REG_ADDR = APB_BUS + 0x1;
    volatile unsigned int status_reg_value = *STATUS_REG_ADDR;

    // Do a write to make waveforms more obvious.
    volatile unsigned int *ANALOG_MUX_ADDR = (uint8_t*) APB_BUS + 0x104;
    *ANALOG_MUX_ADDR = 0x4a;

    
    //FIFO measurement address
    volatile unsigned int *FIFO_MEASUREMENT_ADDR = APB_BUS + 0x002;
 
    int i = 0;
    //Wait until fifo is full or at the least has some measurements.
    volatile unsigned int *ADC_TRIGGER_ADDR = (uint8_t*) APB_BUS + 0x108;
        //Setting LSB to 1 should start ADC conversion.
    *ADC_TRIGGER_ADDR = 0x1;
    *ADC_TRIGGER_ADDR = 0x1;
    *ADC_TRIGGER_ADDR = 0x1;
     *ADC_TRIGGER_ADDR = 0x1;
    *ADC_TRIGGER_ADDR = 0x1;
     *ADC_TRIGGER_ADDR = 0x1;
    *ADC_TRIGGER_ADDR = 0x1;
     *ADC_TRIGGER_ADDR = 0x1;
    *ADC_TRIGGER_ADDR = 0x1;
     *ADC_TRIGGER_ADDR = 0x1;
    *ADC_TRIGGER_ADDR = 0x1;
     *ADC_TRIGGER_ADDR = 0x1;
    *ADC_TRIGGER_ADDR = 0x1;
    *ADC_TRIGGER_ADDR = 0x1;
    *ADC_TRIGGER_ADDR = 0x1;
     *ADC_TRIGGER_ADDR = 0x1;
    *ADC_TRIGGER_ADDR = 0x1;
     *ADC_TRIGGER_ADDR = 0x1;
    *ADC_TRIGGER_ADDR = 0x1;
     *ADC_TRIGGER_ADDR = 0x1;
    *ADC_TRIGGER_ADDR = 0x1;
        *ADC_TRIGGER_ADDR = 0x1;
    *ADC_TRIGGER_ADDR = 0x1;
    *ADC_TRIGGER_ADDR = 0x1;
     *ADC_TRIGGER_ADDR = 0x1;
    *ADC_TRIGGER_ADDR = 0x1;
     *ADC_TRIGGER_ADDR = 0x1;
    *ADC_TRIGGER_ADDR = 0x1;
     *ADC_TRIGGER_ADDR = 0x1;
    *ADC_TRIGGER_ADDR = 0x1;
     *ADC_TRIGGER_ADDR = 0x1;
    *ADC_TRIGGER_ADDR = 0x1;
     *ADC_TRIGGER_ADDR = 0x1;
    *ADC_TRIGGER_ADDR = 0x1;
    *ADC_TRIGGER_ADDR = 0x1;
    *ADC_TRIGGER_ADDR = 0x1;
     *ADC_TRIGGER_ADDR = 0x1;
    *ADC_TRIGGER_ADDR = 0x1;
     *ADC_TRIGGER_ADDR = 0x1;
    *ADC_TRIGGER_ADDR = 0x1;
     *ADC_TRIGGER_ADDR = 0x1;
    *ADC_TRIGGER_ADDR = 0x1;
        
    // while (i < 3) {
    //     volatile unsigned int *ADC_TRIGGER_ADDR = (uint8_t*) APB_BUS + 0x108;
    //     //Setting LSB to 1 should start ADC conversion.
    //     *ADC_TRIGGER_ADDR = 0x1;
    //     i = i+1;
    // }
    // //Was giving an error, commented it out and added back in and it worked?
    // // Keep going until fifo becomes empty. 
    // // Could add some sort of timeout check if required.
    volatile uint32_t low_value = *(FIFO_MEASUREMENT_ADDR+1);
    low_value = *(FIFO_MEASUREMENT_ADDR+1);
    low_value = *(FIFO_MEASUREMENT_ADDR+1);
    volatile uint32_t high_value = *FIFO_MEASUREMENT_ADDR;
    low_value = *(FIFO_MEASUREMENT_ADDR+1);
    low_value = *(FIFO_MEASUREMENT_ADDR+1);
    *ANALOG_MUX_ADDR = 0x4a;
    low_value = *(FIFO_MEASUREMENT_ADDR+1);
    low_value = *(FIFO_MEASUREMENT_ADDR+1);
    low_value = *(FIFO_MEASUREMENT_ADDR+1);
      low_value = *(FIFO_MEASUREMENT_ADDR+1);
    low_value = *(FIFO_MEASUREMENT_ADDR+1);
    low_value = *(FIFO_MEASUREMENT_ADDR+1);
      low_value = *(FIFO_MEASUREMENT_ADDR+1);
    low_value = *(FIFO_MEASUREMENT_ADDR+1);
    low_value = *(FIFO_MEASUREMENT_ADDR+1);
      low_value = *(FIFO_MEASUREMENT_ADDR+1);
    low_value = *(FIFO_MEASUREMENT_ADDR+1);
    low_value = *(FIFO_MEASUREMENT_ADDR+1);
      low_value = *(FIFO_MEASUREMENT_ADDR+1);
    low_value = *(FIFO_MEASUREMENT_ADDR+1);
    low_value = *(FIFO_MEASUREMENT_ADDR+1);
    

    status_reg_value = *STATUS_REG_ADDR;
    // while(status_reg_value & FIFO_STATUS_MASK != 0b00) {
    //     volatile uint32_t high_value = *FIFO_MEASUREMENT_ADDR;
    //     volatile uint32_t low_value = *(FIFO_MEASUREMENT_ADDR+1);
    // //TODO verify this operation is valid.
    //     volatile uint64_t combined_value = (((uint64_t)high_value )<< 32) | low_value;
    //     // uint64_t fifo_value = get_FIFO_value(FIFO_MEASUREMENT_ADDR);
    //     // printf("%d\n", fifo_value);
    //     // i = i+1;
    //       status_reg_value = *STATUS_REG_ADDR;
    // }
    return 0;

}

//NOTE: If ever change map this function has to be rewritten. Magic number isn't great.
volatile unsigned int get_fifo_status(volatile unsigned int *APB_BUS_ADDR) {
    volatile unsigned int *STATUS_REG_ADDR = APB_BUS_ADDR + 0x1;
    volatile unsigned int status_reg_value = *STATUS_REG_ADDR;
    return status_reg_value & FIFO_STATUS_MASK;
}

uint64_t get_FIFO_value(volatile unsigned int* FIFO_MEASUREMENT_ADDR) {
        uint32_t high_value = *FIFO_MEASUREMENT_ADDR;
    uint32_t low_value = *(FIFO_MEASUREMENT_ADDR+1);
    //TODO verify this operation is valid.
    uint64_t combined_value = (((uint64_t)high_value )<< 32) | low_value;
}
