lewisMW/agriculture-SoC/(commit log)

2024-08-11 implemented ARM IP SRAM interface and mock SRAM
2024-08-13 Implemented ARM IP AHB GPIO
2024-08-22 tested current implementation + added instructions
2024-09-28 Fixed SRAM bug and GPIO mem addr. Fixed Flash mem range. GPIO write works now.
    [agriculture_soc.v, hello.c]
2024-09-30 initial stages for adc_apb_wrapper.v
2024-12-09 Accelerator project files
    [cfg_xhb_axi_to_ahb.cfg, cfg_xhb_axi_to_ahb_big.cfg]
2024-12-11 fixed syntax issues to enable compilation
    [dummy_adc.v]
2024-12-18 Attempt to clone the accelerator-project files
    [cfg_xhb_axi_to_ahb.cfg, cfg_xhb_axi_to_ahb_big.cfg]
2024-12-18 instantiation of wrapper, and fixed final compilation issues
    [agriculture_soc.v, dummy_adc.v]
2025-01-19 debug outputs for dummy adc, fixed compilation
    [dummy_adc.v, dummy_amux.v]
2025-02-02 fixed issue with signal changes being printed multiple times
    [dummy_adc.v, dummy_amux.v, dummy_pll.v]
2025-02-02 added debug output on reset
    [dummy_adc.v, dummy_amux.v, dummy_pll.v]
2025-02-04 Migrated from adc-apb-wrapper to FIFO
2025-02-09 fixed measurement data type
    [dummy_adc.v]
2025-02-09 Fixed bug with not storing write data in register causing write data to be overwritten
    [agriculture_soc.v]
2025-02-11 Updated follow lewis's review and modify the trigger logic of dummy adc
2025-02-16 added changes to allow tests to compile. WILL REVERT THIS COMMIT LATER
    [agriculture_soc.v, dummy_amux.v, dummy_pll.v, read_entire_fifo.c]
2025-03-02 modified memory map and fixed bugs in apb bus, fifo, adc
    [adc_apb_fifo_wrapper.v, agriculture_soc.v, fifo_apb_adc.v]
2025-03-02 modified tests for new memory map and fixed issues
    [read_fifo_simple.c]
2025-03-18 Modified wiring of rtc_control module
2025-03-18 bug fixed fifo enable
    [adc_apb_fifo_wrapper.v, dummy_adc.v]
2025-03-18 modified make file to remove optimisation and fixed fifo test
    [read_entire_fifo.c]
2025-05-31 Fix - no register between APB reads
    [dummy_adc.v]
2025-05-31 Squashed 'nanosoc/nanosoc_tech/' content from commit 4646ef1
    git-subtree-dir: nanosoc/nanosoc_tech
    git-subtree-split: 4646ef1b25578b5d810b10589e08bc3379213c92
    [data_in.csv]
2025-07-17 Squashed 'nanosoc/nanosoc_tech/' changes from 4646ef1..e59fb70
    e59fb70 Fix icarus verilog simulation
    8e5aa44 Add gate sims support and begin migration of ASIC flow to ASIC flow subrepository
    git-subtree-split: e59fb7053c55aab66e892b70393965d1741073bb
    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
    [nanosoc_chip_pads_38pin.v, nanosoc_tb_GATE.v]
2025-07-17 Squashed 'nanosoc/asic_lib_tech/' changes from 0977f3e..e8ed1e3
    e8ed1e3 fix tsmc28nm bootrom tie offs
    git-subtree-dir: nanosoc/asic_lib_tech
    git-subtree-split: e8ed1e3ba1877e05937f0b6e6dc240cf9affcee2
    [bootrom.v]
2025-07-17 Squashed 'nanosoc/nanosoc_tech/nanosoc/sldma350_tech/' content from commit a188b6d
    git-subtree-dir: nanosoc/nanosoc_tech/nanosoc/sldma350_tech
    git-subtree-split: a188b6d7dd75c849bf37dc5447a110e73061fbfb
    [cfg_xhb_axi_to_ahb.cfg, cfg_xhb_axi_to_ahb_big.cfg]
2026-02-16 ADC AMS working
    .bashrc to tell your bash terminal where are cadence softwares
    'AMS VERILOG SOC' library with verilog AMS ADC
    'SoC' library with simulations
    [expand.cfg]
2026-02-16 Delete nanosoc/nanosoc_tech/nanosoc/socdebug_tech/socket/uart_axi_master directory
    This was breaking the github website action
2026-02-16 Analog subdirectory (#65)
    * Add ADC library with tb
    * Create Cadence setup manual.pdf
    * gitignore cadence temps
    * mv agriculture_soc_main/CADENCE/* analog
    ---------
    [expand.cfg]
2026-02-16 add amp filter lib (#56)
    [expand.cfg]
2026-02-16 Add documentation for filter and amplifier testbench v1 (#64)
    Added documentation for the Verilog-A testbench of a filter and amplifier front end, detailing features, design constraints, simulation results and next steps.
2026-03-02 dac block, fsm not yet (#70)
    [expand.cfg]
2026-04-14 Analog high level modules and testbenches (#77)
    ## Libraries Created
    ### adc_primitives_lib
    - **capacitor_adc** - behavioural Verilog-AMS model of an ideal capacitor
    - **inverter** - behavioural Verilog-AMS model of an ideal inverter
    ### adc_analog_lib
    - **comparator** - behavioural Verilog-AMS model of a differential comparator with 5-bit trima/trimb calibration bus
    - **switch** - behavioural Verilog-AMS model of an analog switch
    - **cap_array_8b** - behavioural Verilog-AMS model of an 8-bit capacitor array
    ### adc_digital_lib
    - **sarlogic** - SAR ADC finite state machine (FSM) control logic
    - **sr_latch** - SR latch primitive
    ### adc_top_lib
    - **cdac_8b** - 8-bit capacitive DAC top lev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
    [expand.cfg]
2026-04-30 Analog cleanup and addition of capacitive DAC and SAR logic modules (#95)
    * clean up. Removal of directories. Addition of testbenches for sarlogic (FSM) and CDAC.
    * clean up
    [expand.cfg]
2026-06-13 Analog SKY130 implementation initiated
    See analog/cadence/cds.lib and analog/cadence/bashrc.
    [expand.cfg]
2026-07-19 Add sky130 analog caps (#117)
    * Add custom capacitor cells to sky130_analog_lib
    Import the SAR ADC custom capacitor cells (comparator trim + main DAC)
    from the sky130_cw_ip design into sky130_analog_lib as self-contained
    OA cellviews:
2026-07-20 Erick ADC test bench complete (#118)
    * testing block for the adc
    base fequency 10khz, change of state of en, rst and cal every 2000 cycles
    [expand.cfg]
2026-07-29 Rtc fsm integration (#72)
    * dummy adc updated to match specs
    * rtc controller bugs fixed
    * fsm, fifo and wrapper updated and memory map
    * fixed fifo tb
    * verification tests
    * working rtl with associated tests
    * modified bootrom generator to control width
    * integrated 1hz clk into accelerator_subsystem for rtc
    * added firmware testing files, peripheral driver, and help function to facilitate removing stdio from test files to shrink firmware size
    [accelerator_subsystem.v, adc_apb_wrapper_rand_tb.v, adc_apb_wrapper_rev2.v, adc_apb_wrapper_rev2_tb.v, agriculture_soc.v, arm_rtc_tb.v, dummy_adc.v, fifo_apb_adc.v]
2026-08-01 Inverter & SAR TB (#101)
    Clean up SAR and Inverter TB directory structure
    [expand.cfg]
2026-09-02 Synthesis workflow and scripts (#112)
    * hostio4 release
    * Fix README.md table format
    * Fix syntax
    * Delete temporary extio8x4.pioasm~
    * Delete temporary hostio4.pioasm~
    * Delete temporary pioxio.py~
    * upgrade to v2 and systemverilog
    * Squashed 'nanosoc/nanosoc_tech/' changes from e59fb70..df2b9d7
    df2b9d7 updated socket/extio8x4 status polarity to match hostio4
    15fd218 updated socket/extio8x4 status polarity to match hostio4
    b62dc11 repair hostio4 gitmodules link
    97f5a0f fix run_vcs spelling in makefile.regression (was run_vcx?)
    1bde9fa reorder regression testing makefile targets (bootrom first)
    d7e26f2 adding hostio in to submodules
    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
    [accelerator_subsystem.v, apb_interrupt_router.v, bootloader.c, bootrom.v, cfg_dma_axi_millisoc.yaml, cocotb_top.sv]
2026-09-28 Analog sky130 clean up (#126)
    * capacitive array with sky130 pdk created. db, oa, and cfg files are still been tracked for testbench. Double check if they have to be tracked.
    * Sar_ref delete it because it is not part of the design anymore. Layout for capacitive array started
    * inverter, cap_array_8b, and cdac_8b schematic and layout done. First stages of LVS and DRC
    * new library created for easy testing. Note: to visualise better the different cells turn on categories in lib manager
    * all testbenches working, but the top tb_sar_adc
    * LVS modification working, but mim cap not working
    * mim_cap_adc LVS working. Switched from PEGASUS241 to PEGASUS 232, a but in .pvl file regarding met2_pin
    [expand.cfg, physExpand.cfg, prop.cfg]
2026-09-28 Erick Comparator (#127)
    Comparator
    [physExpand.cfg, prop.cfg]
2026-09-30 Bootstrap sw (#120)
    * bootstrap switch schematic + layout
    * BS switch layout continued with Pegasus run, DRC errors not involving capacitors or density addressed
    * bootstrap switch lib update up to parasitic extraction
2026-10-23 Sky130 analog updates: carray_8b/cdac_8b, Quantus extracted views, PDK env fixes (#130)
    * Sky130 analog updates: carray_8b/cdac_8b layout, Quantus extracted views, PDK env fixes
    - Rename carray_8b_test -> carray_8b and consolidate test -> cdac_8b work
    - Update carray_8b, cdac_8b, inverter, mim_cap_adc, mim_cap_2bank
    layout/schematic
    - Add Quantus av_extracted views for carray_8b, inverter, mim_cap_adc
    - Add QUANTUSHOME to bashrc; remove incorrect pv/ library definition
    from cds.lib
    Branched fresh from main to avoid carrying pre-squash history from
    the old analog-sky130-hee-dev branch (which conflicted against main
    due to PR #126's squash merge).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
2026-10-23 Erick dev (#131)
    * Trim: fix pins so DRC and LVS are clean
    - sarcta__C0 layout: cn label was plain text on met2 drawing, so Pegasus
    ignored it ("missing pin cn"); replaced with a real cn pin on met2 pin.
    - Trim layout/schematic: top-level pins (d<0..4>, drain, Vss) on pin
    purpose layers so they are recognised by the sky130 LVS deck.
    Pegasus LVS (sky130.lvs.v0.0_1.1.pvl): MATCH, extraction clean.
    Pegasus DRC: 0 results across 578 rule checks.
    * Comparator: fix layout, LVS clean (sky130 Pegasus)
    - Remove duplicate right-hand Trim instance (overlapped 5 nm offset)
    - Add top-level pins/labels: Vn, Vp, Out_N, Out_P, Vdd, Trima<4:0>,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
2026-10-23 ASIC_ours sky130 flow: flow fixes, synthesisable RTL, floorplan, power plan and pad ring (#134)
    * constraints: qualify multicycle exceptions with -setup/-hold
    Eight set_multicycle_path statements were declared with no -setup/-hold
    qualifier. In SDC an unqualified multiplier applies to BOTH checks, so each
    also moved the hold capture edge a full cycle later. Internal clk->clk paths
    were consequently hold-checked against the NEXT clock edge, reporting
    fictional violations up to -35 ns.
    Lines 34-37 already did this correctly (-setup 2 paired with -hold 1); the
    statements at 43, 55-57, 59, 65 and the two inside the foreach at 73-74 did
    not. Each is now split into a -setup N / -hold N-1 pair. S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
2026-10-23 SKY130 AMS Integration (#122)
    * pv: batch DRC, LVS and extraction for the analog libraries
    analog/cadence/pv runs the sky130 sign-off of the sar_adc cells headless on
    the Cadence box:
    - run_lvs.sh: strmout + si (auCdl) + Pegasus LVS, with --blackbox for
    Erick's MOM unit cap and --exclude-hcell to compare a sub-cell
    flattened.
    - run_drc.sh: Pegasus DRC, real rules separated from density/fill.
    - run_pex.sh: LVS --rc, then Quantus rc_coupled, then a Spectre netlist
    whose ports must match the schematic's.
    - netlist_spectre.sh, and rebind_moved.il for cells moved between
    libraries.
    - lvs_deck.sh patches three bugs in the PDK's Pegasus LVS deck (met2 pins
    never attach, MIM caps crash Pe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
2026-10-26 ASIC_ours/Cadence: well taps, decap/fill mix, tie-cell limit, post-route DRC stage
    Fixes to the place and route flow that the 23 Sep chip's sign-off DRC and LVS
    exposed. None of them depends on the ADC macro.
    - preplace.tcl: place well taps (sky130_fd_sc_hd__tapvpwrvgnd_1, every 14 um
    per row). The flow placed none, so nwell.4/nwell.ntap failed in every
    standard-cell row and the design had no latch-up protection.
    - filler.tcl: fill with decaps up to 40 % of the free space, then plain fill
    cells. Fill cells hold no diffusion, poly or li1, so the front-end density
    rules failed; all-decap overshoots CDRW.poly.local.high. Drop
    add_filler_gaps, which after routing moved 2,376 routed ce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
2026-10-26 ASIC_ours/Cadence: place and route the chip with the sar_afe macro; fix the floorplan, pad ring and power plan
    Puts the ADC macro (ASIC_ours/macros/sar_afe) into the chip flow and fixes the
    floorplan, pad ring and power plan faults that came to light on the way. The
    floorplan and power plan changes are interleaved in floorplan.tcl and
    power_plan.tcl, so they are one commit.
    Macro and analog pads
    - config.tcl, nanosoc_chip_pads.mmmc: the macro's LEF and per-corner .lib files,
    the analog pad stubs library, the reset pad's libraries (Genus black-boxed
    that pad and stopped without them), VDDA as a power net.
    - nanosoc_chip_pads.v: ports ADC_VINP/ADC_VINN, two sky130_ef_io__analog_pad
    inst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
2026-11-01 add power detector, vref to design. Modify power plan to match
2026-11-10 fix floorplan and power plan. Adjust drc + lvs steps to account for newly added modules
